byteofsoren/kicad_bytelib/3D/10A10-T/3D/10A10-T.stp

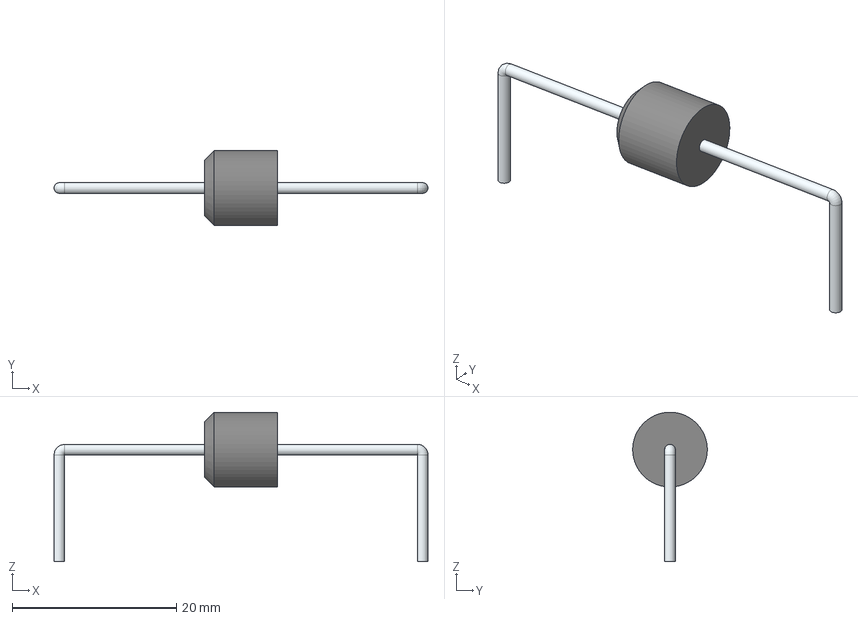
[picture p1: CAD file, 2021-05-24]
3D/10A10-T/3D/10A10-T.stp
45.5 x 9.10 x 18.2 mm
