byteofsoren/kicad_bytelib/3D/219-3LPSTR/3D/219-3LPSTR.stp

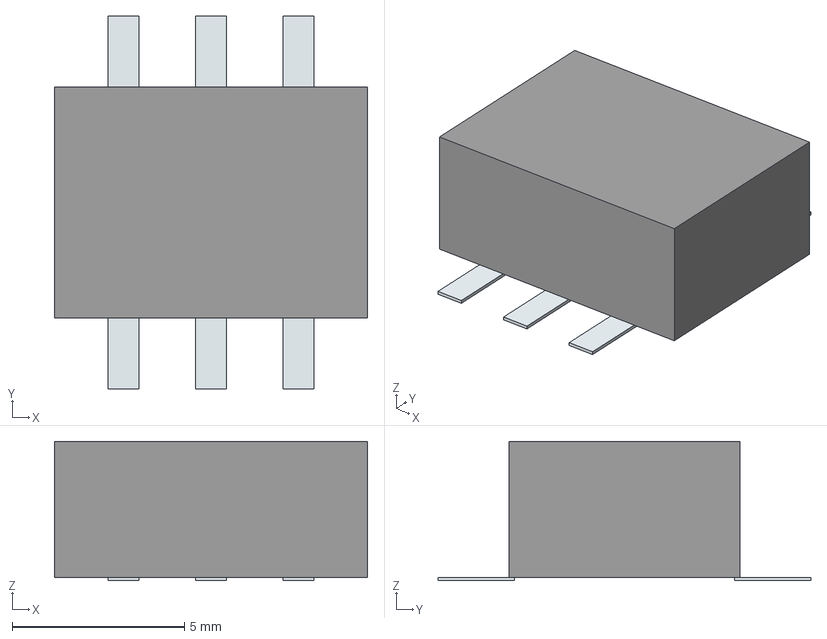
[picture p2: CAD file, 2021-05-24]
3D/219-3LPSTR/3D/219-3LPSTR.stp
9.09 x 10.8 x 4.05 mm
('pin',_'1')
('pin',_'2')
('pin',_'3')
('pin',_'4')
('pin',_'5')
('pin',_'6')
