byteofsoren/kicad_bytelib/3D/4628/3D/4628.stp

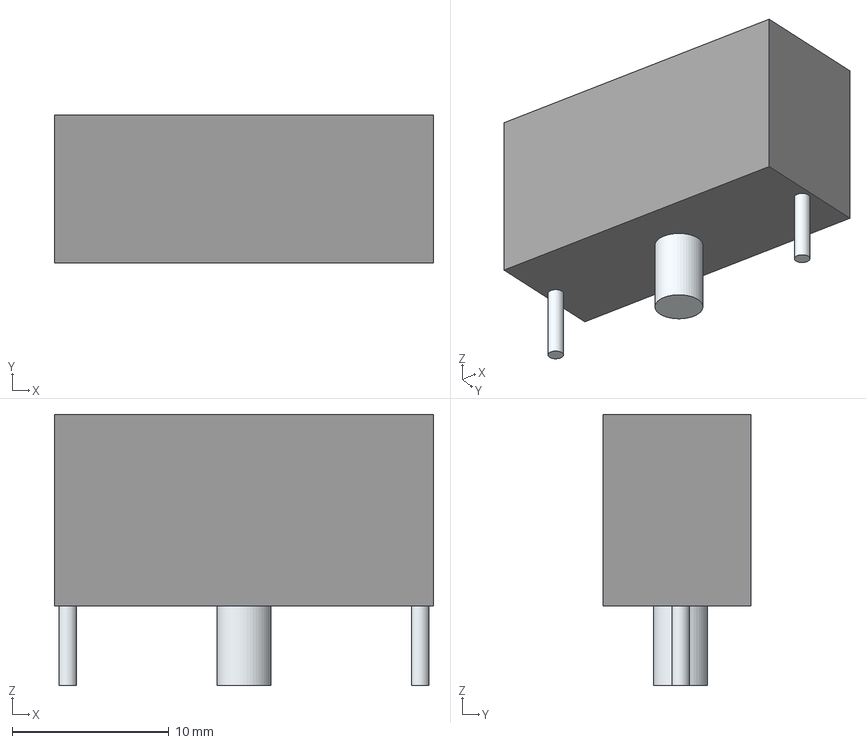
[picture p3: CAD file, 2021-05-24]
3D/4628/3D/4628.stp
24.2 x 9.45 x 17.3 mm
Leads x 3
