byteofsoren/kicad_bytelib/3D/ADS7830IPWR/3D/ADS7830IPWR.stp

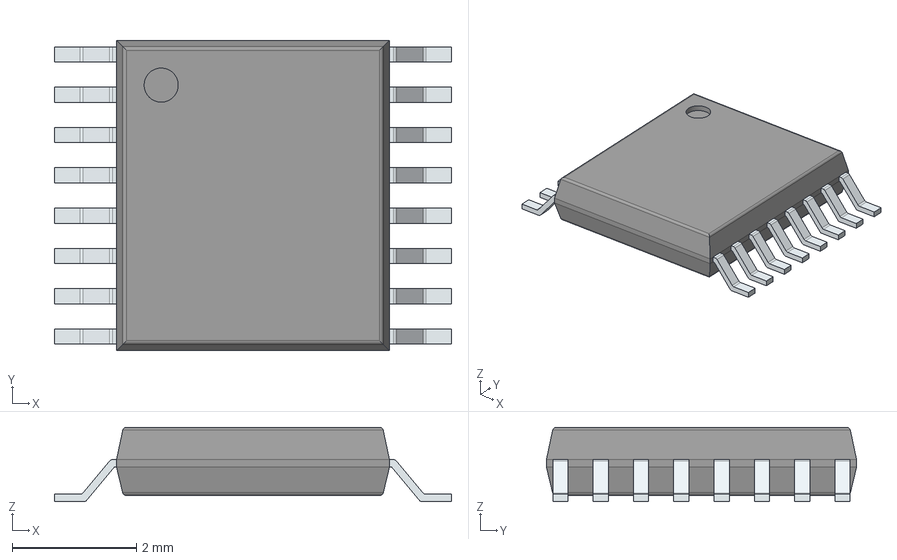
[picture p4: CAD file, 2021-05-24]
3D/ADS7830IPWR/3D/ADS7830IPWR.stp
6.40 x 5.00 x 1.20 mm
PinsArrayLR
