byteofsoren/kicad_bytelib/3D/ADUM1400ARWZ-RL/3D/ADUM1400ARWZ-RL.stp

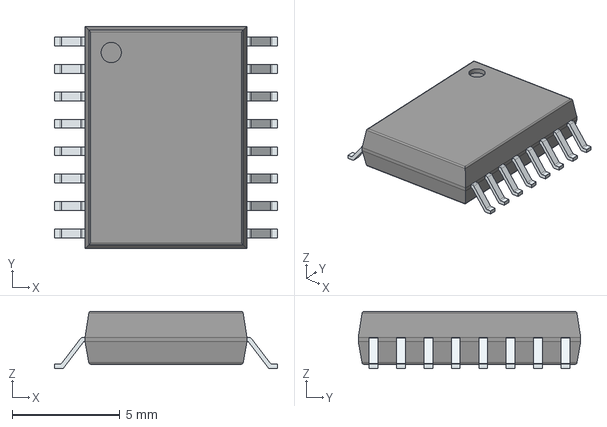
[picture p5: CAD file, 2021-05-24]
3D/ADUM1400ARWZ-RL/3D/ADUM1400ARWZ-RL.stp
10.3 x 10.3 x 2.65 mm
PinsArrayLR
