byteofsoren/kicad_bytelib/3D/CMI-9705-0580-SMT-TR/3D/CMI-9705-0580-SMT-TR.stp

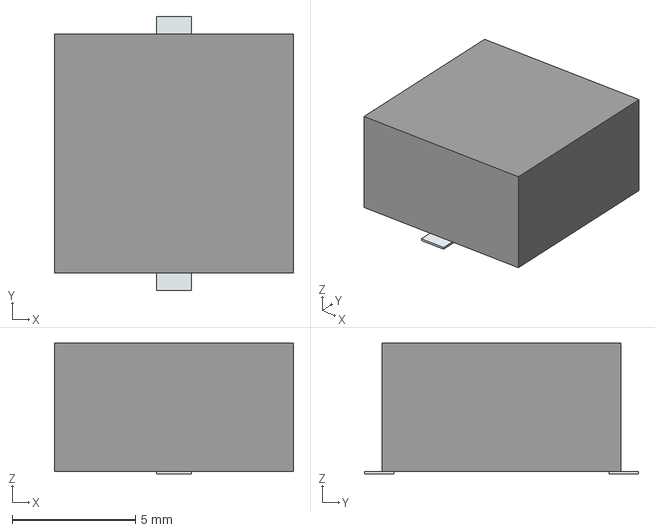
[picture p6: CAD file, 2021-05-24]
3D/CMI-9705-0580-SMT-TR/3D/CMI-9705-0580-SMT-TR.stp
9.70 x 11.1 x 5.30 mm
Pins
