byteofsoren/kicad_bytelib/3D/DLW44SM401SK2L/3D/DLW44SM401SK2L.stp

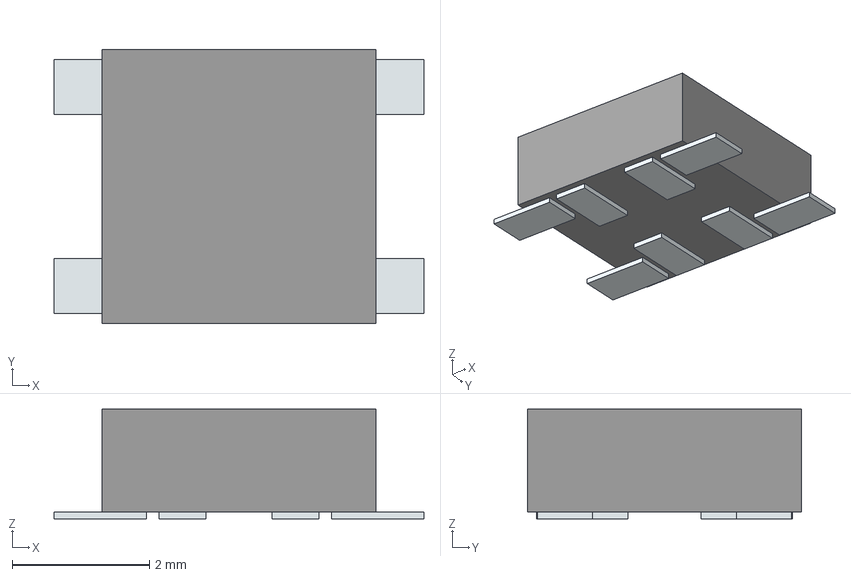
[picture p7: CAD file, 2021-05-24]
3D/DLW44SM401SK2L/3D/DLW44SM401SK2L.stp
5.40 x 4.00 x 1.60 mm
Pins
