byteofsoren/kicad_bytelib/3D/EDZCVT2R6.8B/3D/EDZCVT2R6.8B.stp

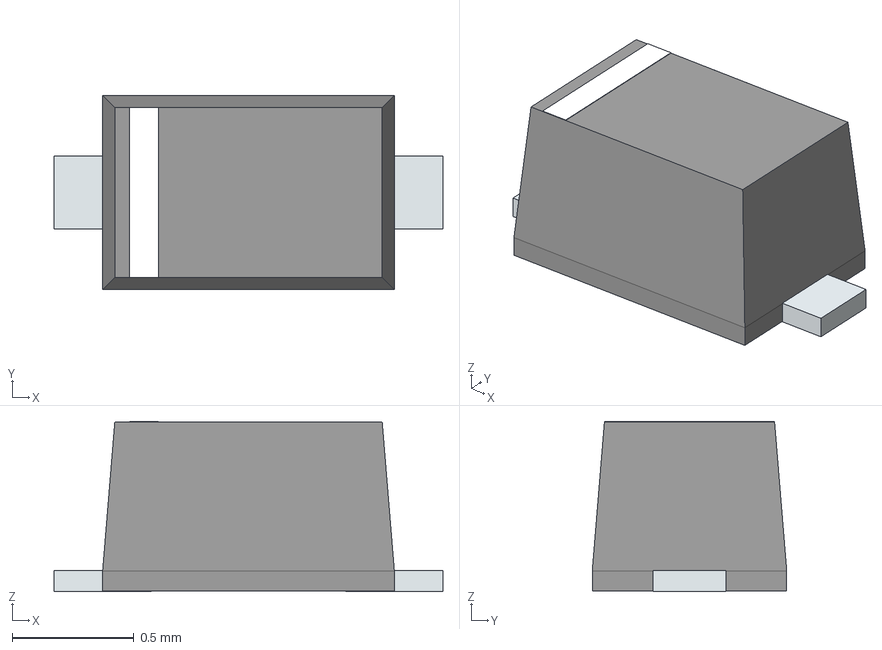
[picture p8: CAD file, 2021-05-24]
3D/EDZCVT2R6.8B/3D/EDZCVT2R6.8B.stp
1.60 x 0.8 x 0.7 mm
PinKIdent
PinK
PinA
