byteofsoren/kicad_bytelib/3D/FQT3P20TF/3D/FQT3P20TF.stp

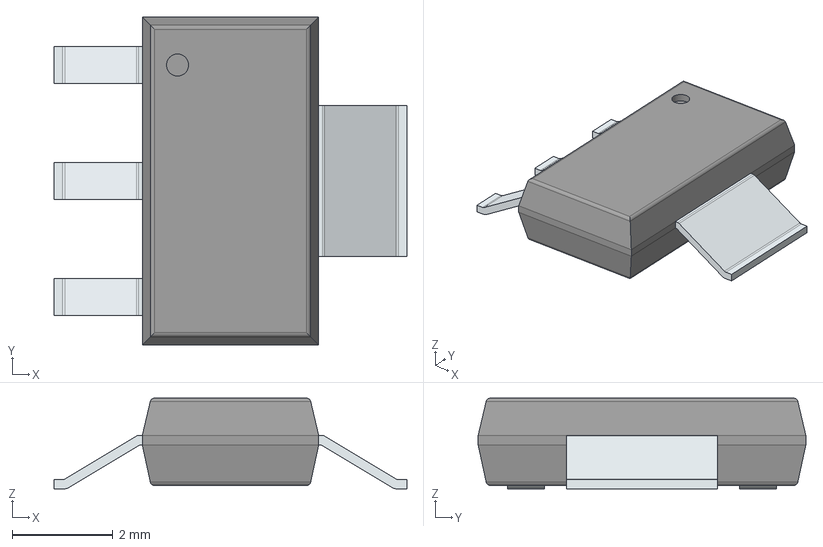
[picture p9: CAD file, 2021-05-24]
3D/FQT3P20TF/3D/FQT3P20TF.stp
7.00 x 6.50 x 1.80 mm
PinsArrayL
FilletPinR
