byteofsoren/kicad_bytelib/3D/IRF9520NPBF/3D/IRF9520NPBF.stp

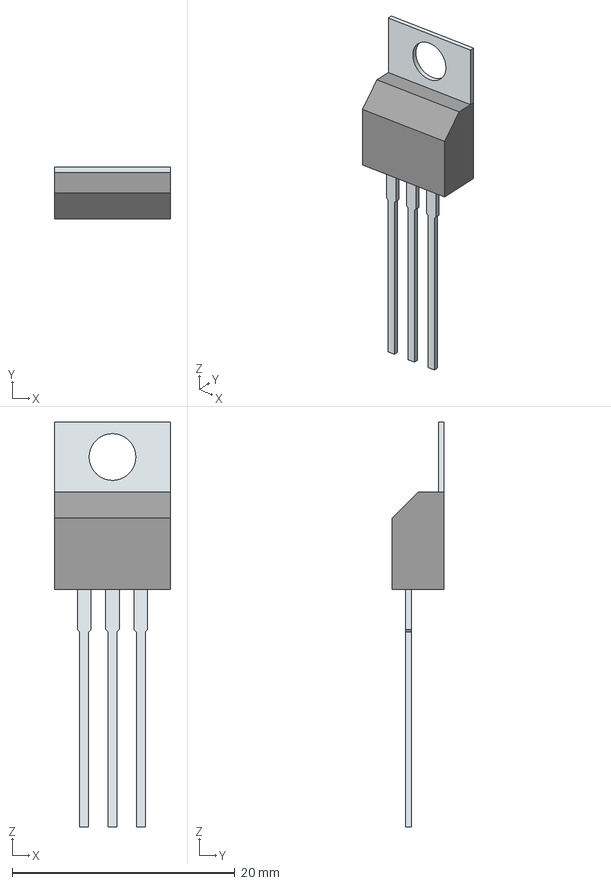
[picture p10: CAD file, 2021-05-24]
3D/IRF9520NPBF/3D/IRF9520NPBF.stp
10.4 x 4.69 x 36.4 mm
Tab
PinsArray
