byteofsoren/kicad_bytelib/3D/LCB717S/3D/LCB717S.stp

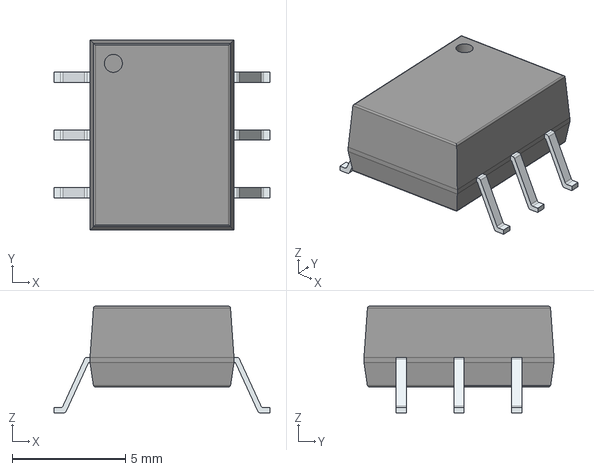
[picture p11: CAD file, 2021-05-24]
3D/LCB717S/3D/LCB717S.stp
9.52 x 8.38 x 4.70 mm
PinsArrayLR
