byteofsoren/kicad_bytelib/3D/LMZM23601V5SILR/3D/LMZM23601V5SILR.stp

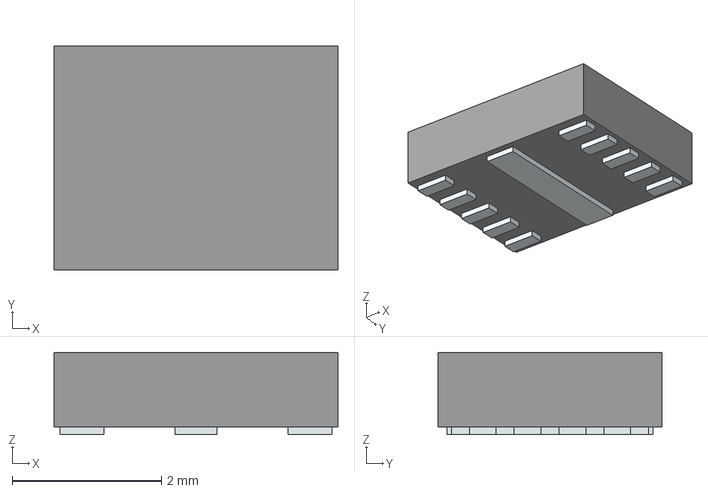
[picture p12: CAD file, 2021-05-24]
3D/LMZM23601V5SILR/3D/LMZM23601V5SILR.stp
3.80 x 3.00 x 1.10 mm
Pins
