byteofsoren/kicad_bytelib/3D/NFA18SL227V1A45L/3D/NFA18SL227V1A45L.stp

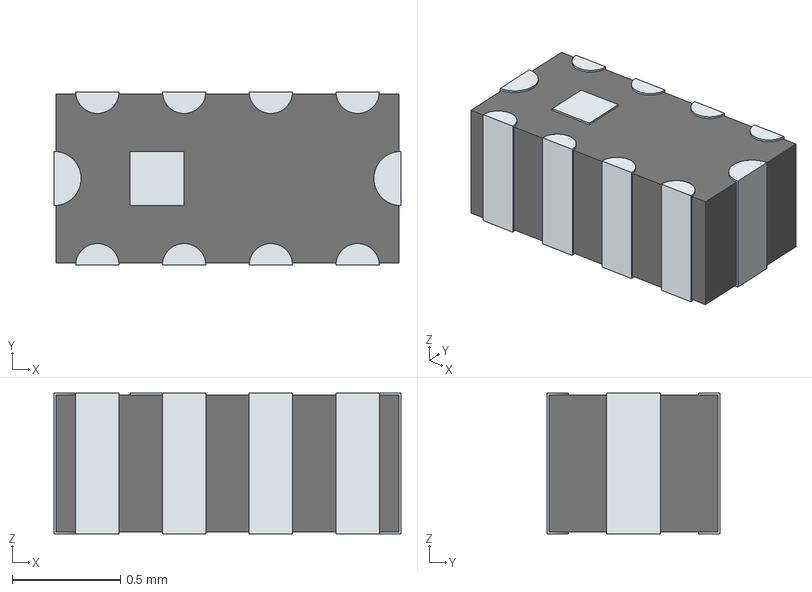
[picture p13: CAD file, 2021-05-24]
3D/NFA18SL227V1A45L/3D/NFA18SL227V1A45L.stp
1.60 x 0.8 x 0.65 mm
Rect1
Rect2
