byteofsoren/kicad_bytelib/3D/NFM21PC104R1E3D/3D/NFM21PC104R1E3D.stp

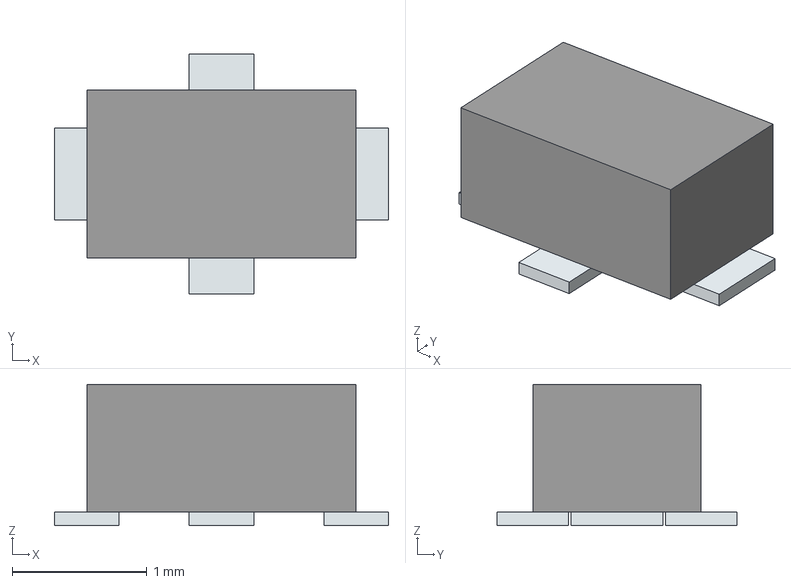
[picture p14: CAD file, 2021-05-24]
3D/NFM21PC104R1E3D/3D/NFM21PC104R1E3D.stp
2.48 x 1.78 x 1.05 mm
Pins
