byteofsoren/kicad_bytelib/3D/NTJS3151PT1G/3D/NTJS3151PT1G.stp

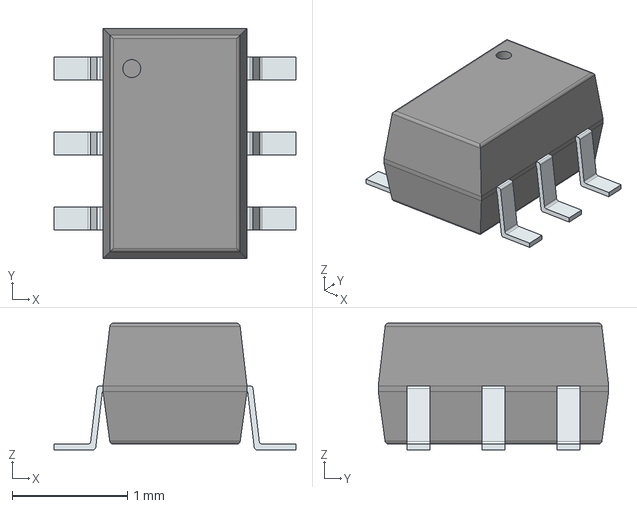
[picture p15: CAD file, 2021-05-24]
3D/NTJS3151PT1G/3D/NTJS3151PT1G.stp
2.10 x 2.00 x 1.10 mm
PinsArrayLR
