byteofsoren/kicad_bytelib/3D/NX2016SA-32M-EXS00A-CS06465/3D/NX2016SA-32M-EXS00A-CS06465.stp

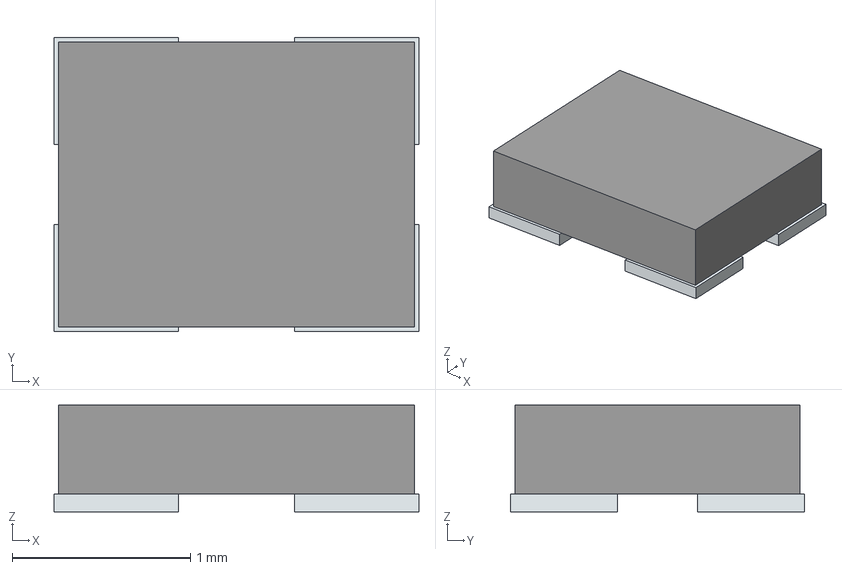
[picture p16: CAD file, 2021-05-24]
3D/NX2016SA-32M-EXS00A-CS06465/3D/NX2016SA-32M-EXS00A-CS06465.stp
2.05 x 1.65 x 0.6 mm
Pins
