byteofsoren/kicad_bytelib/3D/P78E05-1000/3D/P78E05-1000.stp

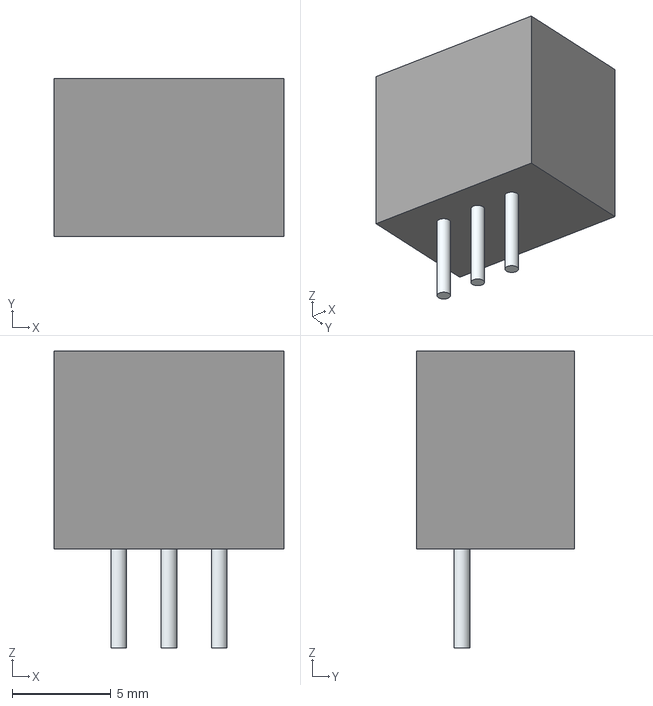
[picture p17: CAD file, 2021-05-24]
3D/P78E05-1000/3D/P78E05-1000.stp
11.6 x 8.00 x 15.0 mm
Leads x 3
