byteofsoren/kicad_bytelib/3D/PDQE15-Q24-S3-D/CUI_PDQE15-Q24-S3-D.step

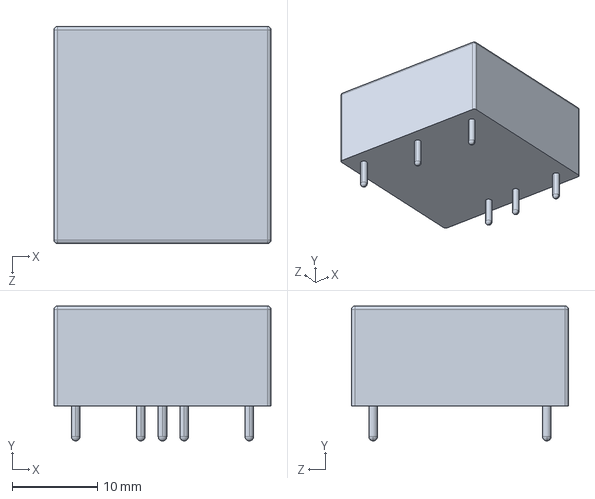
[picture p18: CAD file, 2021-05-24]
3D/PDQE15-Q24-S3-D/CUI_PDQE15-Q24-S3-D.step
25.4 x 15.8 x 25.4 mm
