byteofsoren/kicad_bytelib/3D/R82DC3330AA60J/3D/R82DC3330AA60J.stp

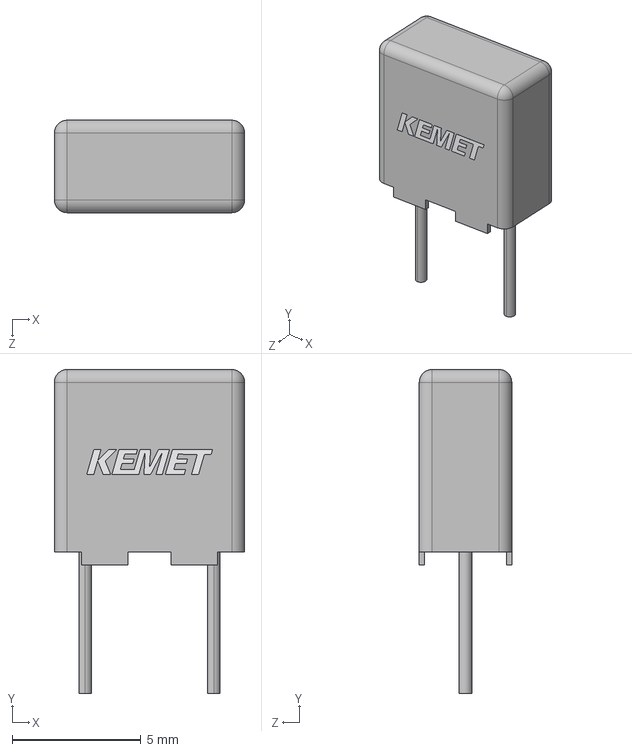
[picture p19: CAD file, 2021-05-24]
3D/R82DC3330AA60J/3D/R82DC3330AA60J.stp
7.40 x 12.6 x 3.60 mm
