byteofsoren/kicad_bytelib/3D/RPMB12-3.0-CT/3D/RPMB12-3.0-CT.stp

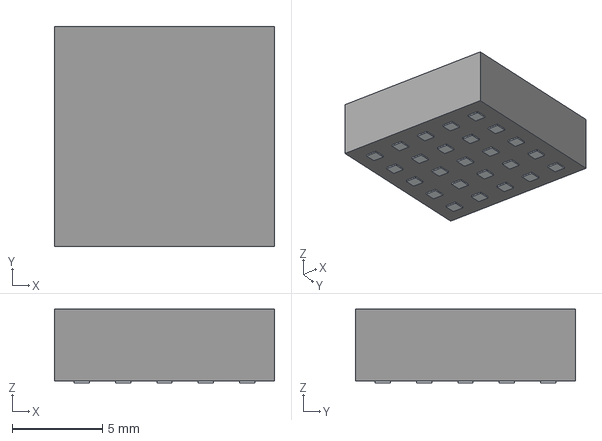
[picture p20: CAD file, 2021-05-24]
3D/RPMB12-3.0-CT/3D/RPMB12-3.0-CT.stp
12.2 x 12.2 x 4.10 mm
Pins
