byteofsoren/kicad_bytelib/3D/SI8602AC-B-ISR/3D/SI8602AC-B-ISR.stp

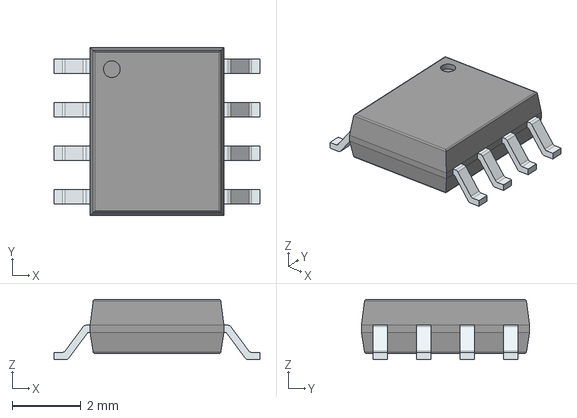
[picture p21: CAD file, 2021-05-24]
3D/SI8602AC-B-ISR/3D/SI8602AC-B-ISR.stp
6.00 x 4.90 x 1.75 mm
PinsArrayLR
