byteofsoren/kicad_bytelib/3D/SI8641AB-B-IS1R/3D/SI8641AB-B-IS1R.stp

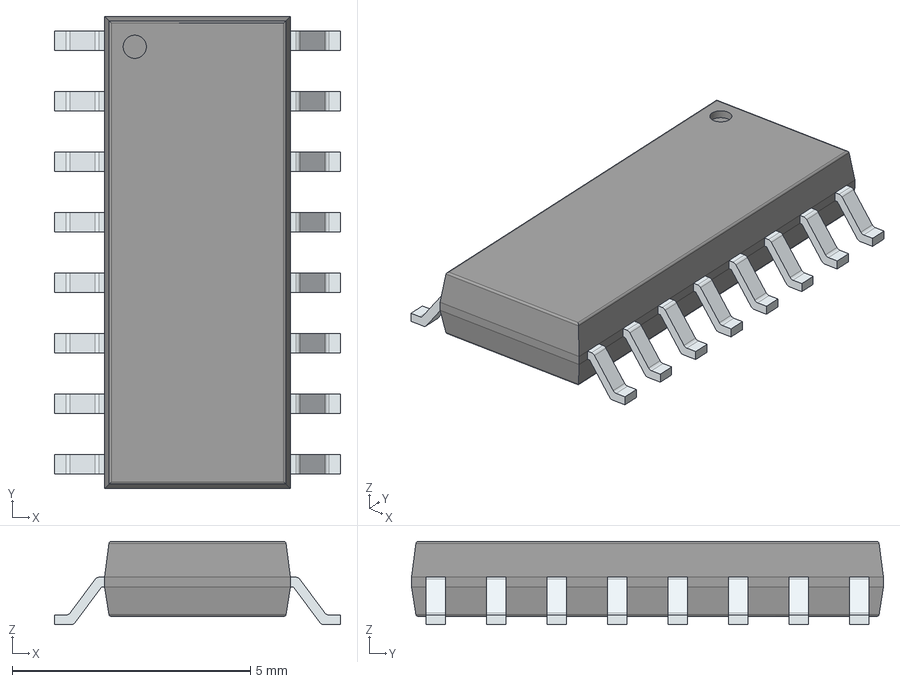
[picture p22: CAD file, 2021-05-24]
3D/SI8641AB-B-IS1R/3D/SI8641AB-B-IS1R.stp
6.00 x 9.90 x 1.75 mm
PinsArrayLR
