byteofsoren/kicad_bytelib/3D/SM4001PL-TP/3D/SM4001PL-TP.stp

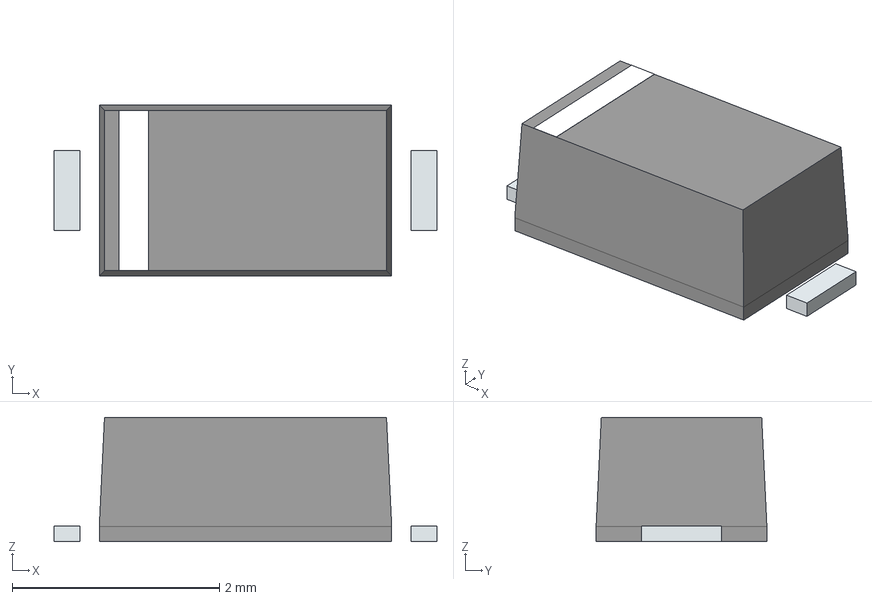
[picture p23: CAD file, 2021-05-24]
3D/SM4001PL-TP/3D/SM4001PL-TP.stp
3.70 x 1.65 x 1.20 mm
PinKIdent
PinK
PinA
