byteofsoren/kicad_bytelib/3D/STM32WB55RGV6/3D/STM32WB55RGV6.stp

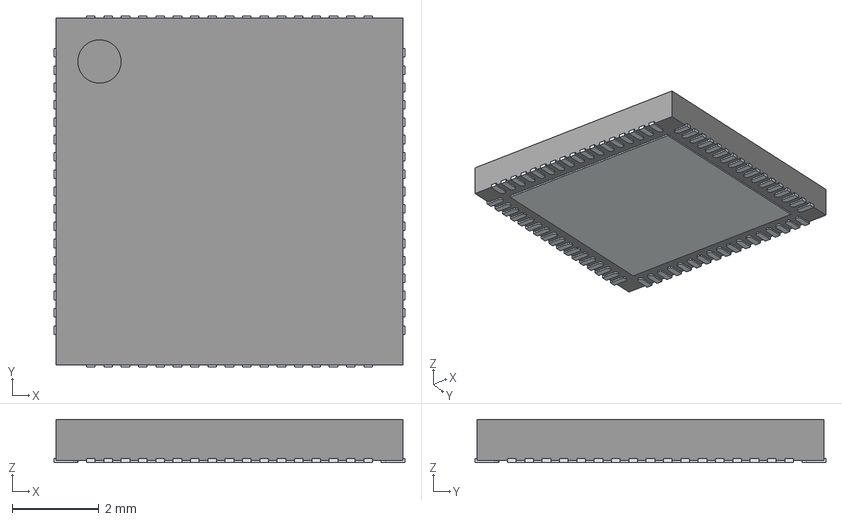
[picture p24: CAD file, 2021-05-24]
3D/STM32WB55RGV6/3D/STM32WB55RGV6.stp
8.10 x 8.10 x 1.00 mm
ThermalPin
PinsArrayLR
PinsArrayTB
