byteofsoren/kicad_bytelib/3D/TEN_60-2412WIN/3D/TEN_60-2412WIN.stp

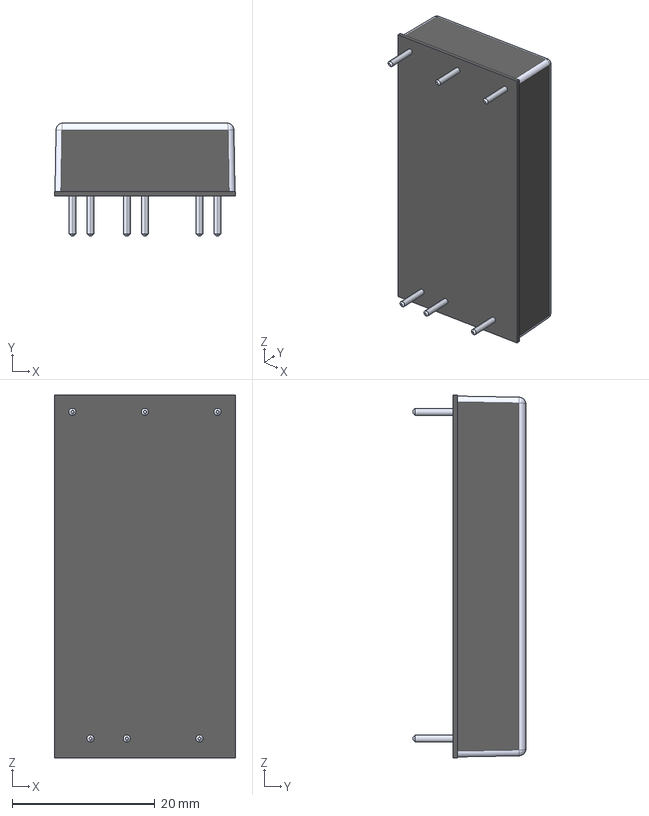
[picture p26: CAD file, 2021-05-24]
3D/TEN_60-2412WIN/3D/TEN_60-2412WIN.stp
25.4 x 15.8 x 50.8 mm
