byteofsoren/kicad_bytelib/3D/THJP/THJP1225A.stp

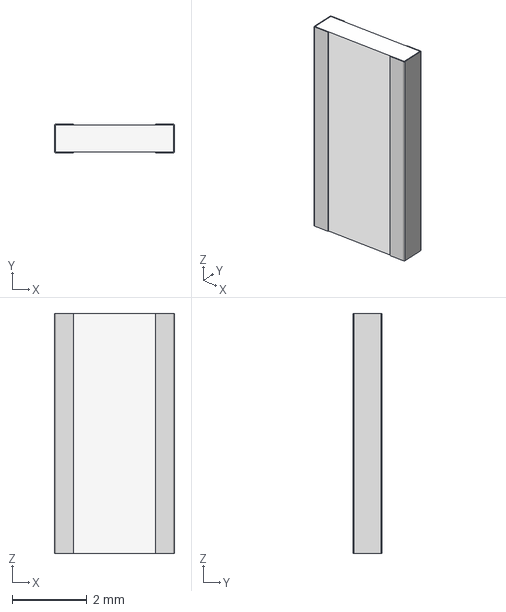
[picture p27: CAD file, 2021-05-24]
3D/THJP/THJP1225A.stp
3.20 x 0.762 x 6.40 mm
