byteofsoren/kicad_bytelib/3D/TMUX1247DCKR/3D/TMUX1247DCKR.stp

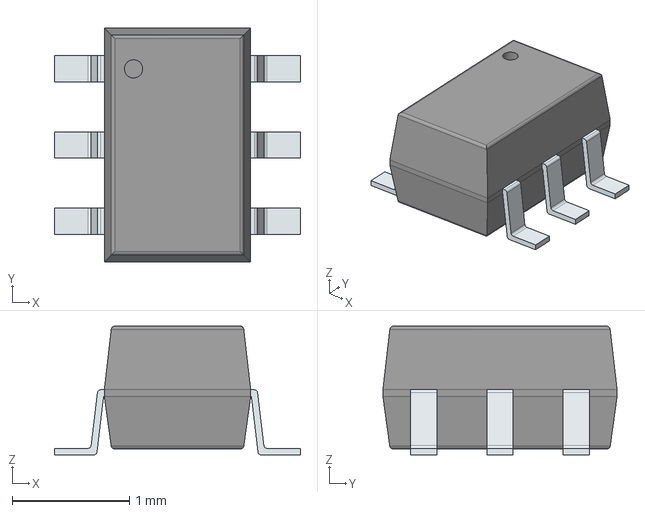
[picture p28: CAD file, 2021-05-24]
3D/TMUX1247DCKR/3D/TMUX1247DCKR.stp
2.10 x 2.00 x 1.10 mm
PinsArrayLR
