byteofsoren/kicad_bytelib/3D/TPS2120YFPR/3D/TPS2120YFPR.stp

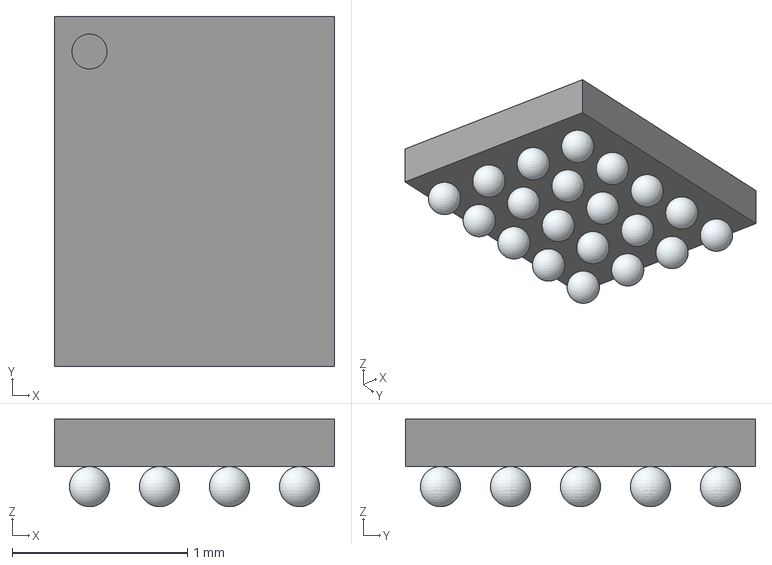
[picture p29: CAD file, 2021-05-24]
3D/TPS2120YFPR/3D/TPS2120YFPR.stp
1.60 x 2.00 x 0.5 mm
