byteofsoren/kicad_bytelib/3D/TSC-124D3H,000/3D/TSC-124D3H,000.stp

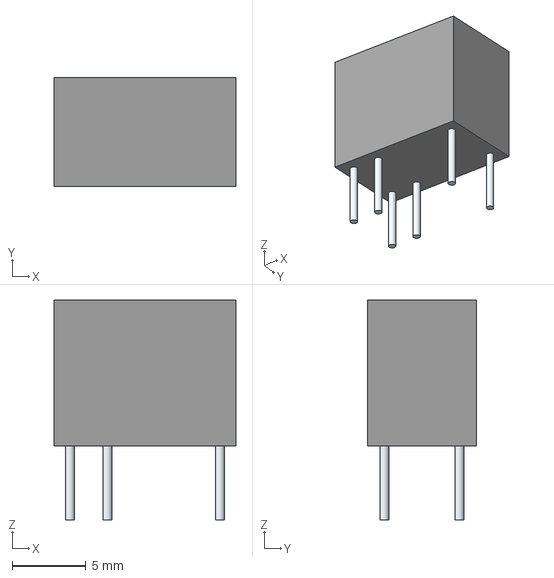
[picture p30: CAD file, 2021-05-24]
3D/TSC-124D3H,000/3D/TSC-124D3H,000.stp
12.3 x 7.40 x 14.9 mm
Leads x 6
