byteofsoren/kicad_bytelib/3D/UA78M33CDCYR/3D/UA78M33CDCYR.stp

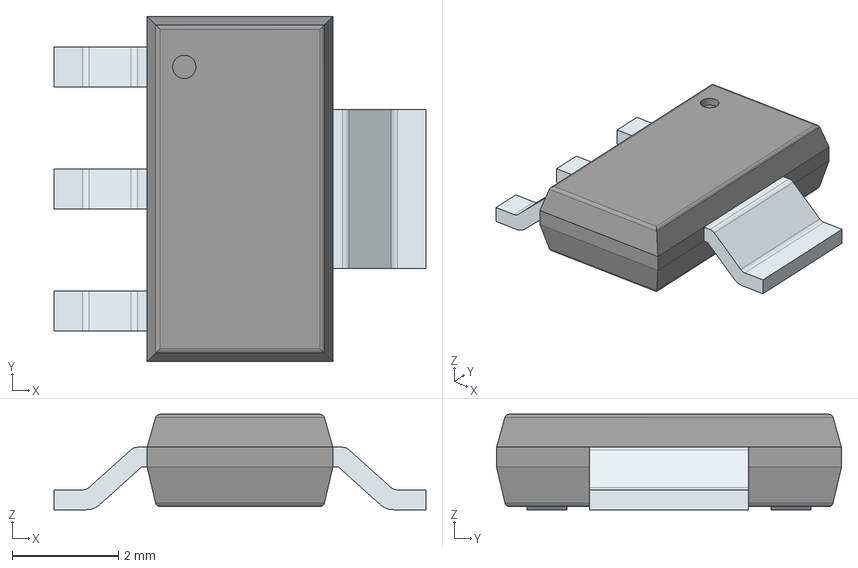
[picture p31: CAD file, 2021-05-24]
3D/UA78M33CDCYR/3D/UA78M33CDCYR.stp
7.00 x 6.50 x 1.80 mm
PinsArrayL
FilletPinR
