byteofsoren/kicad_bytelib/3D/UWT1H101MNL1GS/3D/UWT1H101MNL1GS.stp

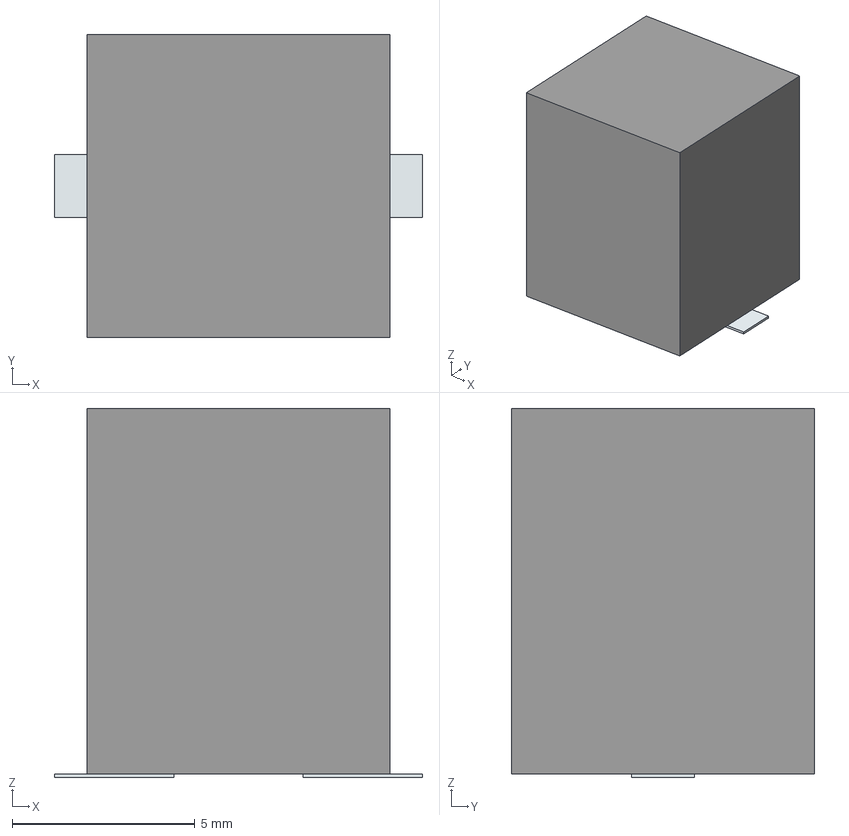
[picture p32: CAD file, 2021-05-24]
3D/UWT1H101MNL1GS/3D/UWT1H101MNL1GS.stp
10.1 x 8.30 x 10.1 mm
('pin',_'1')
('pin',_'2')
