byteofsoren/kicad_bytelib/3D/WCAP-ASLI_rev19a/10x10R5x4R5/10x10.5x4.5.stp

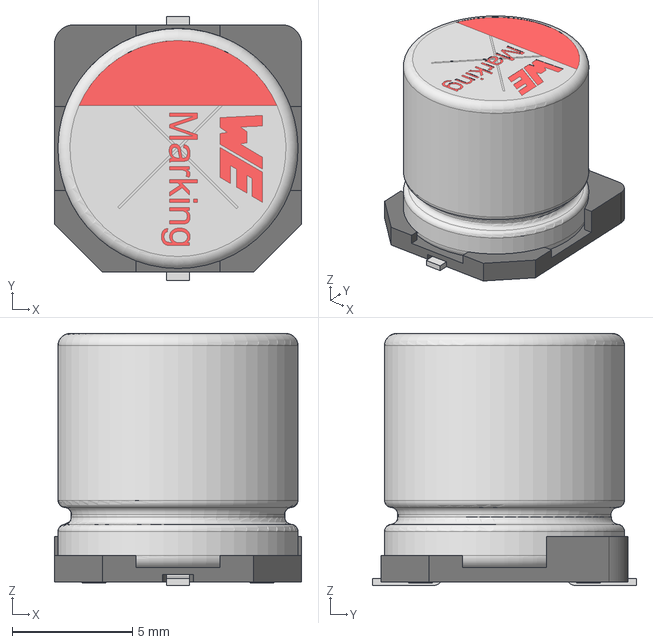
[picture p33: CAD file, 2021-05-24]
3D/WCAP-ASLI_rev19a/10x10R5x4R5/10x10.5x4.5.stp
10.3 x 11.0 x 10.5 mm
capicitor_10x10.5x4.5
Base_Φ10Capacitor
