byteofsoren/kicad_bytelib/3D/WCAP-ASLI_rev19a/12R5x14x4R5/12.5x14x4.5.stp

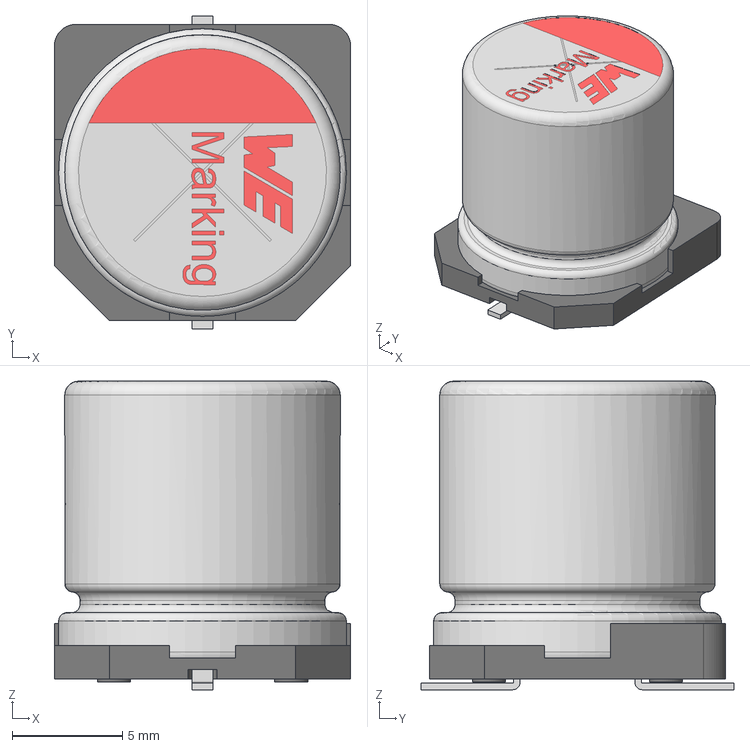
[picture p34: CAD file, 2021-05-24]
3D/WCAP-ASLI_rev19a/12R5x14x4R5/12.5x14x4.5.stp
13.4 x 14.2 x 14.0 mm
capicitor_12.5x14x4.5
Base_Φ13Capacitor
