byteofsoren/kicad_bytelib/3D/WCAP-ASLI_rev19a/16x17x7/16x17x7.stp

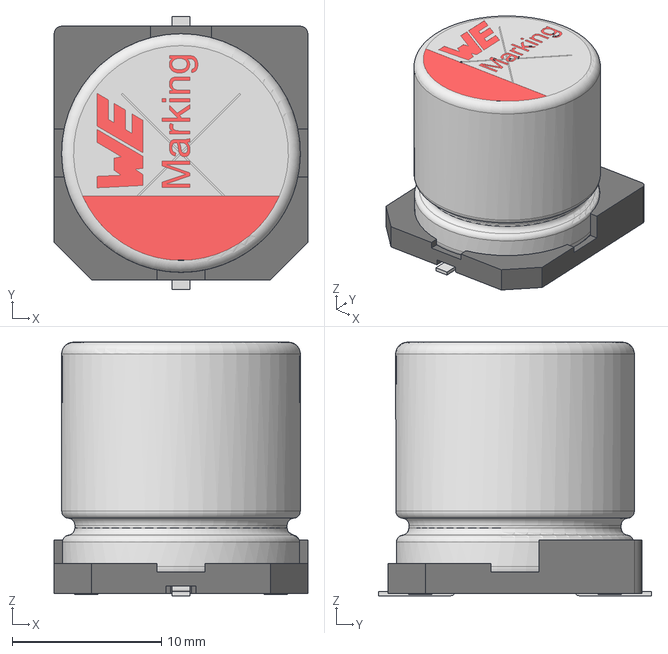
[picture p35: CAD file, 2021-05-24]
3D/WCAP-ASLI_rev19a/16x17x7/16x17x7.stp
17.0 x 18.3 x 17.0 mm
Base_Φ16Capacitor
capicitor_16x17x7
