byteofsoren/kicad_bytelib/3D/WCAP-ASLI_rev19a/4x5R5x1/4x5.5x1.stp

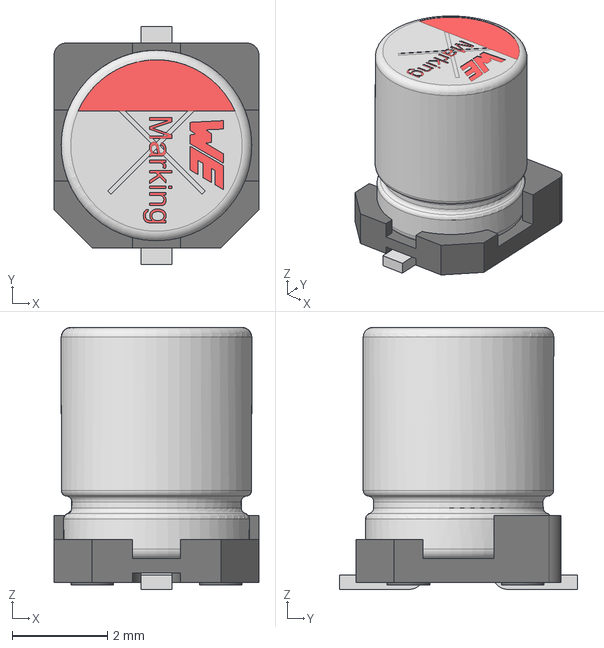
[picture p36: CAD file, 2021-05-24]
3D/WCAP-ASLI_rev19a/4x5R5x1/4x5.5x1.stp
4.30 x 5.00 x 5.50 mm
capicitor_4x5.5x1
Base_Φ4Capacitor
