byteofsoren/kicad_bytelib/3D/WCAP-ASLI_rev19a/5x5R5x1R4/5x5.5x1.4.stp

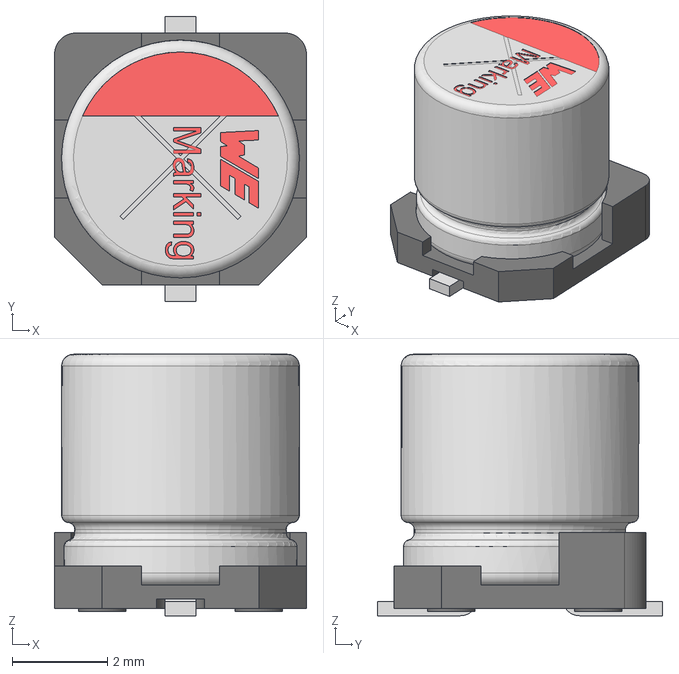
[picture p37: CAD file, 2021-05-24]
3D/WCAP-ASLI_rev19a/5x5R5x1R4/5x5.5x1.4.stp
5.30 x 6.00 x 5.50 mm
capicitor_5x5.5x1.4
Base_Φ5Capacitor
