byteofsoren/kicad_bytelib/3D/WCAP-ASLI_rev19a/6R3x7R7x2R2/6.3x7.7x2.2.stp

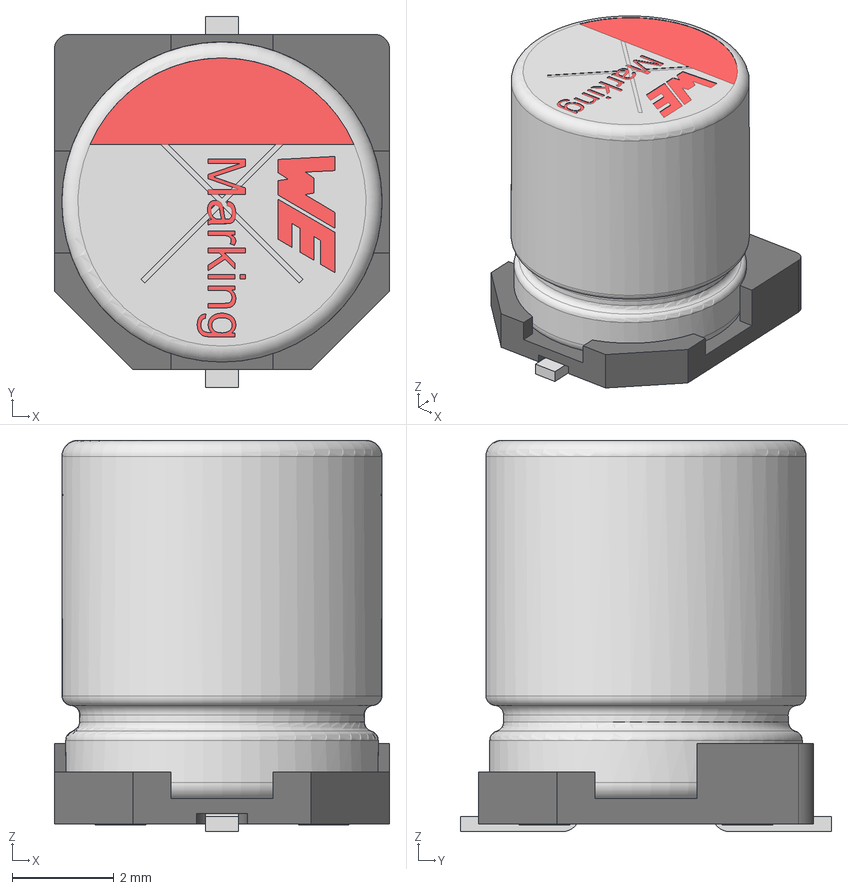
[picture p38: CAD file, 2021-05-24]
3D/WCAP-ASLI_rev19a/6R3x7R7x2R2/6.3x7.7x2.2.stp
6.60 x 7.30 x 7.70 mm
capicitor_6.3x7.7x2.2
Base_Φ6_3Capacitor
