byteofsoren/kicad_bytelib/3D/WCAP-ASLI_rev19a/8x10R5x3R1/8x10.5x3.1.stp

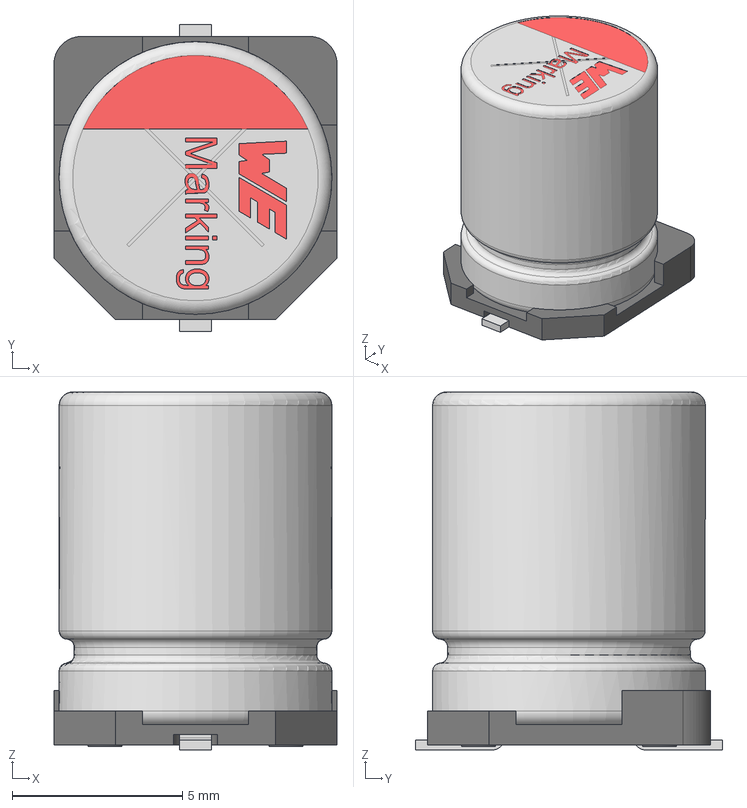
[picture p39: CAD file, 2021-05-24]
3D/WCAP-ASLI_rev19a/8x10R5x3R1/8x10.5x3.1.stp
8.30 x 9.00 x 10.5 mm
capicitor_8x10.5x3.1
Base_Φ8Capacitor
