byteofsoren/kicad_bytelib/3D/WCAP-ASLI_rev19a/8x6R5x2R3/8x6.5x2.3.stp

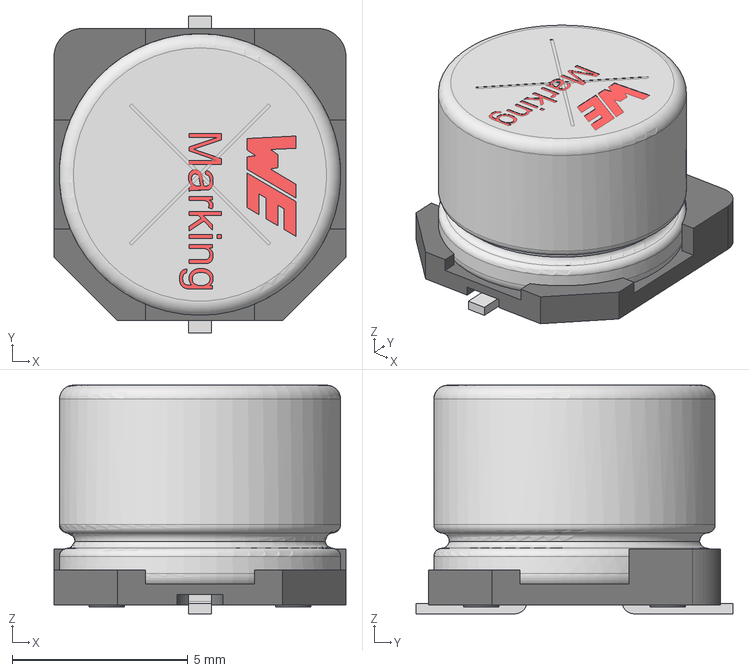
[picture p40: CAD file, 2021-05-24]
3D/WCAP-ASLI_rev19a/8x6R5x2R3/8x6.5x2.3.stp
8.30 x 9.00 x 6.50 mm
capicitor_8x6.5x2.3
Base_Φ8Capacitor
