byteofsoren/kicad_bytelib/3D/WE-PD_744777.stp

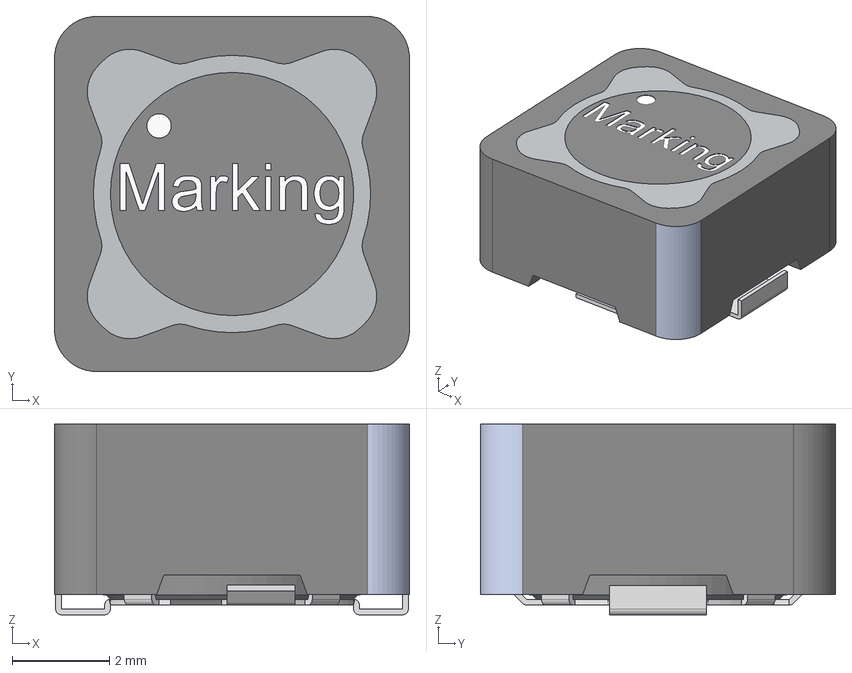
[picture p41: CAD file, 2022-03-26]
3D/WE-PD_744777.stp
7.30 x 7.30 x 3.92 mm
Ring
Core
Base x 2
Glue x 3
