byteofsoren/kicad_bytelib/3D/THJP/THJP0805A.stp

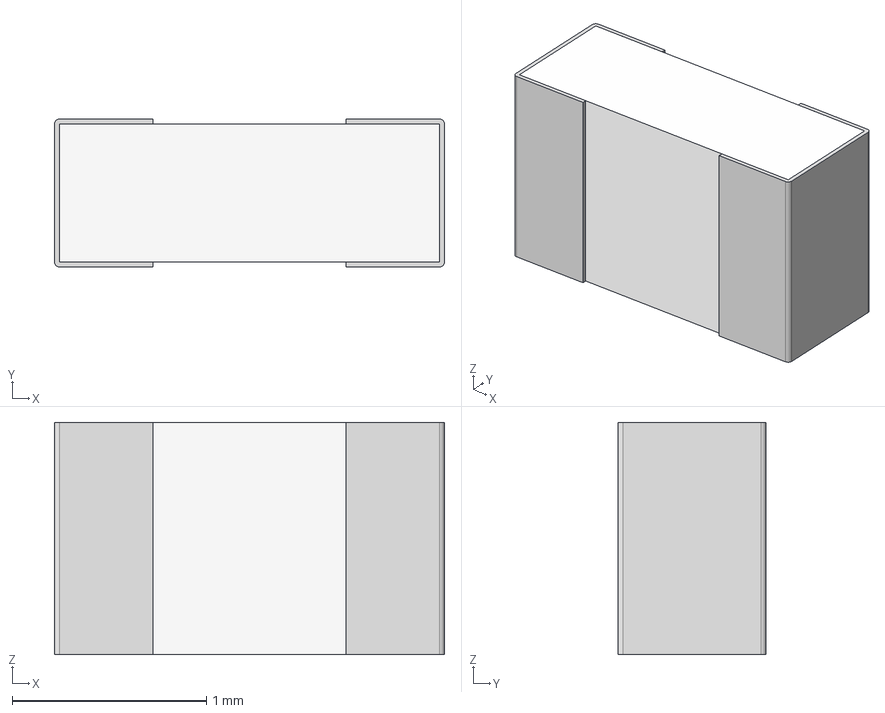
[picture p43: CAD file, 2021-05-24]
3D/THJP/THJP0805A.stp
2.01 x 0.762 x 1.19 mm
