byteofsoren/kicad_bytelib/3D/TBL009V-254/CUI_DEVICES_TBL009V-254-05GY-2GY.step

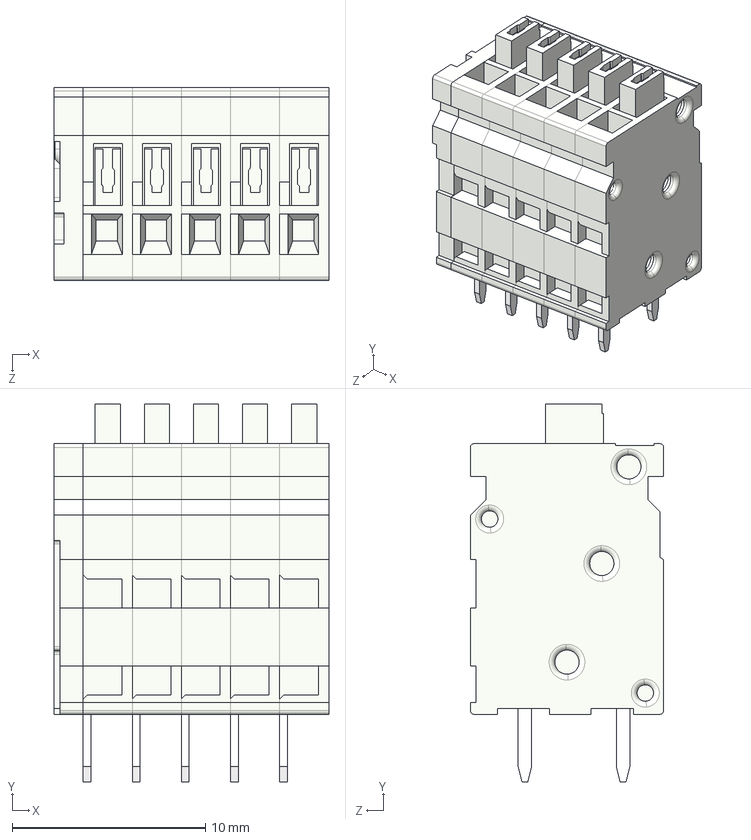
[picture p44: CAD file, 2021-05-24]
3D/TBL009V-254/CUI_DEVICES_TBL009V-254-05GY-2GY.step
14.2 x 19.6 x 10.0 mm
TBL009V-254 - END CAP_Gray
TBL009V-254 - BODY_Gray x 5
TBL009V-254 - PUSH BUTTON_Gray x 5
