byteofsoren/kicad_bytelib/3D/THJP/THJP0612A.stp

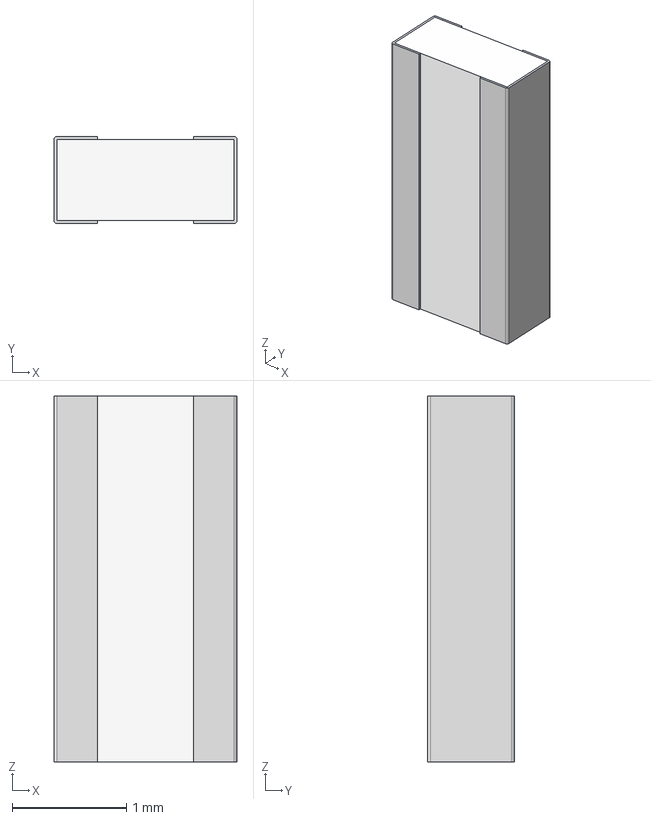
[picture p45: CAD file, 2021-05-24]
3D/THJP/THJP0612A.stp
1.60 x 0.762 x 3.20 mm
