byteofsoren/kicad_bytelib/3D/TBL009V-254/CUI_DEVICES_TBL009V-254-12GY-2GY.step

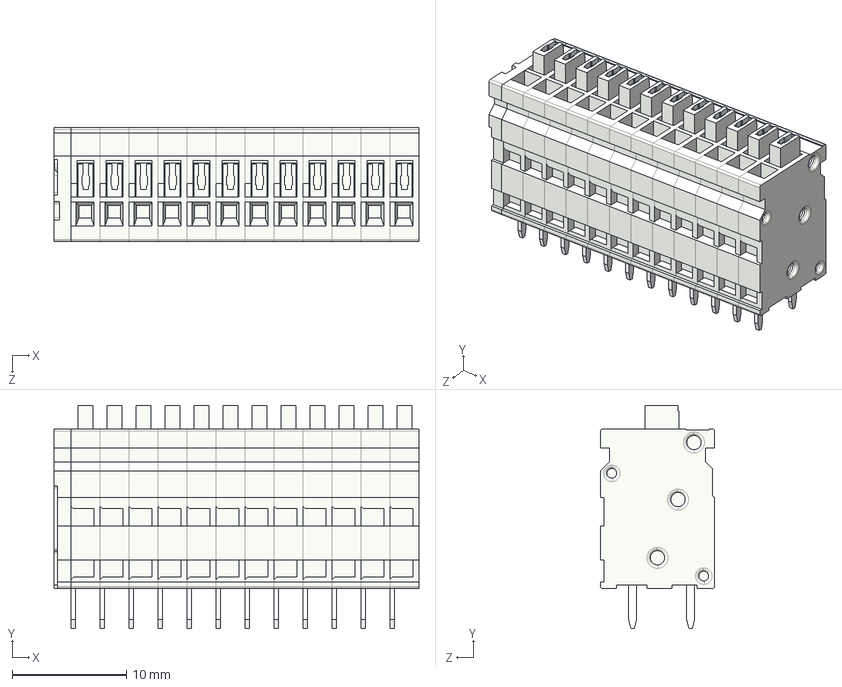
[picture p46: CAD file, 2021-05-24]
3D/TBL009V-254/CUI_DEVICES_TBL009V-254-12GY-2GY.step
32.0 x 19.6 x 10.0 mm
TBL009V-254 - END CAP_Gray
TBL009V-254 - BODY_Gray x 12
TBL009V-254 - PUSH BUTTON_Gray x 12
