byteofsoren/kicad_bytelib/3D/THJP/THJP1206A.stp

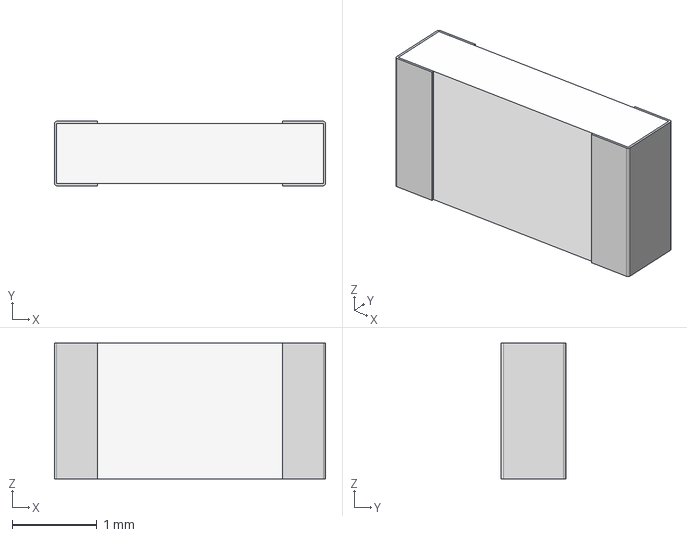
[picture p47: CAD file, 2021-05-24]
3D/THJP/THJP1206A.stp
3.20 x 0.762 x 1.60 mm
