byteofsoren/kicad_bytelib/3D/THN_15-1210.stp

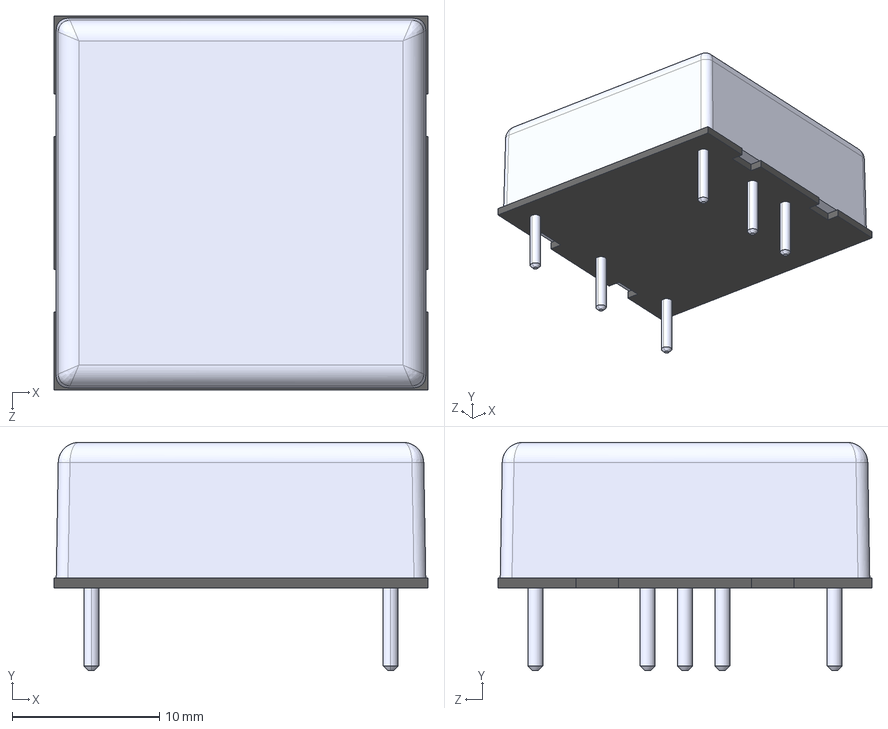
[picture p48: CAD file, 2022-01-19]
3D/THN_15-1210.stp
25.4 x 15.5 x 25.4 mm
