byteofsoren/kicad_bytelib/3D/THJP/THJP0603A.stp

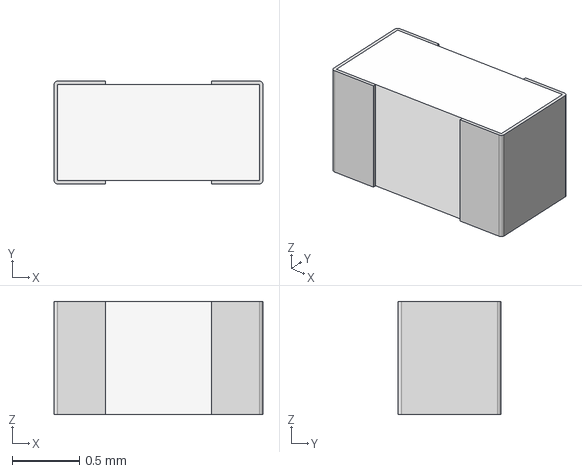
[picture p49: CAD file, 2021-05-24]
3D/THJP/THJP0603A.stp
1.55 x 0.762 x 0.838 mm
