byteofsoren/kicad_bytelib/3D/WE-CNSW_1206_CNSW.stp

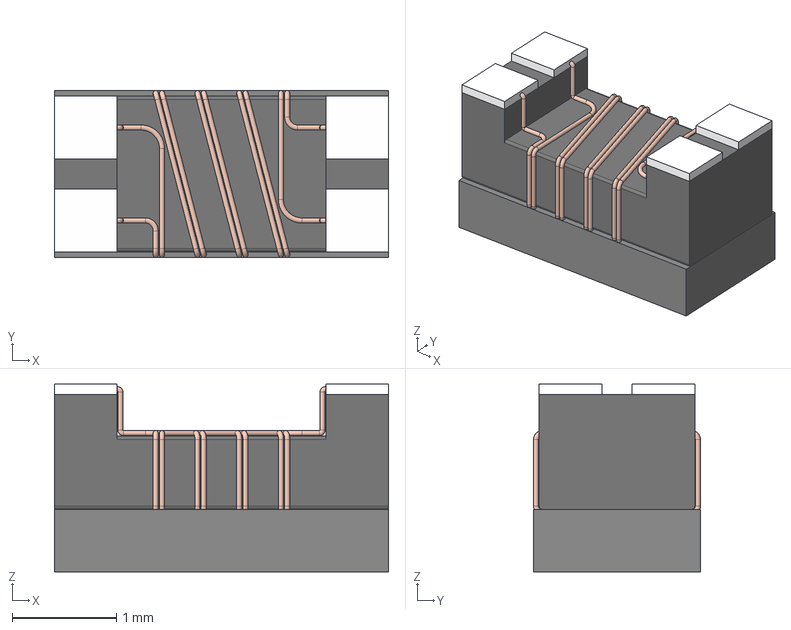
[picture p50: CAD file, 2021-12-19]
3D/WE-CNSW_1206_CNSW.stp
3.20 x 1.60 x 1.80 mm
Gehäuse x 3
Boden
Lötfläche x 4
