byteofsoren/kicad_bytelib/3D/THJP/THJP2512A.stp

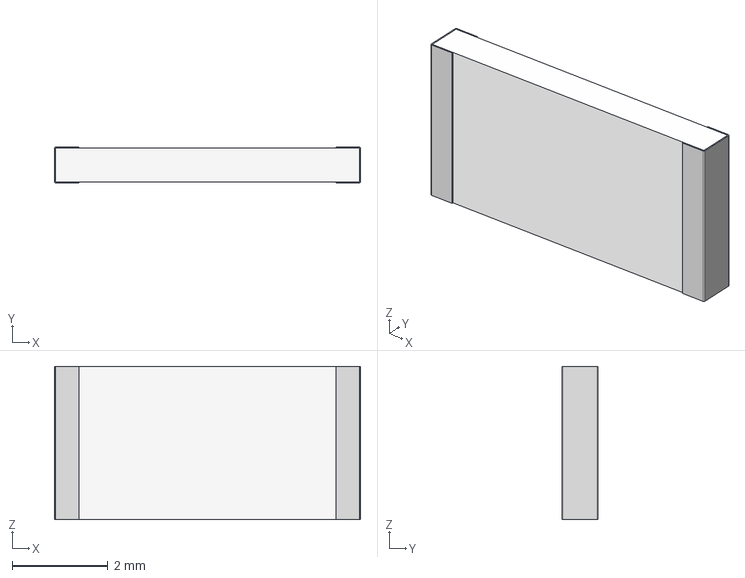
[picture p51: CAD file, 2021-05-24]
3D/THJP/THJP2512A.stp
6.40 x 0.762 x 3.20 mm
