byteofsoren/kicad_bytelib/3D/ADUM4160BRIZ-RL.stp

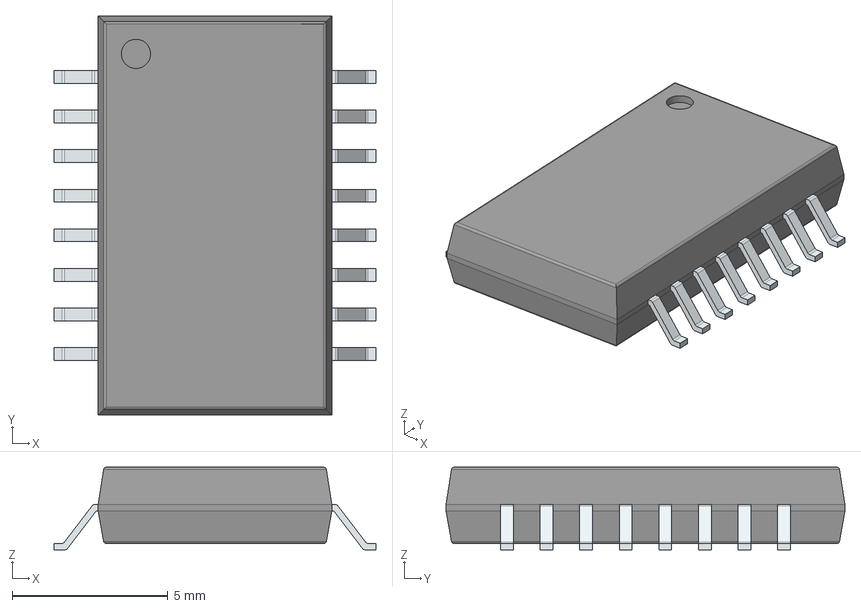
[picture p52: CAD file, 2021-09-27]
3D/ADUM4160BRIZ-RL.stp
10.3 x 12.8 x 2.65 mm
PinsArrayLR
