byteofsoren/kicad_bytelib/3D/TL3780AF240QG.stp

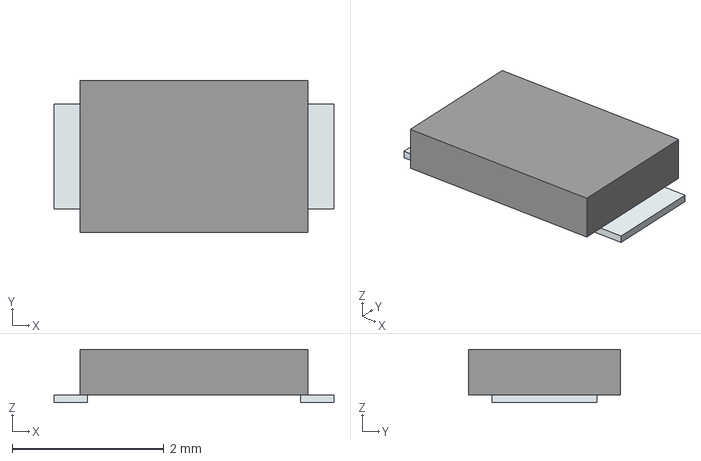
[picture p53: CAD file, 2021-09-27]
3D/TL3780AF240QG.stp
3.69 x 2.00 x 0.7 mm
Pins
