byteofsoren/kicad_bytelib/3D/TEN_3-0510N.stp

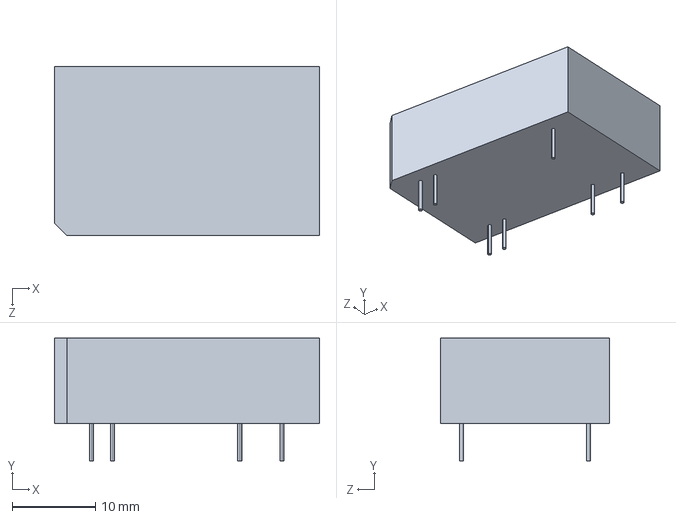
[picture p54: CAD file, 2021-09-27]
3D/TEN_3-0510N.stp
31.8 x 14.7 x 20.3 mm
