byteofsoren/kicad_bytelib/3D/TPS2121RUXR.step

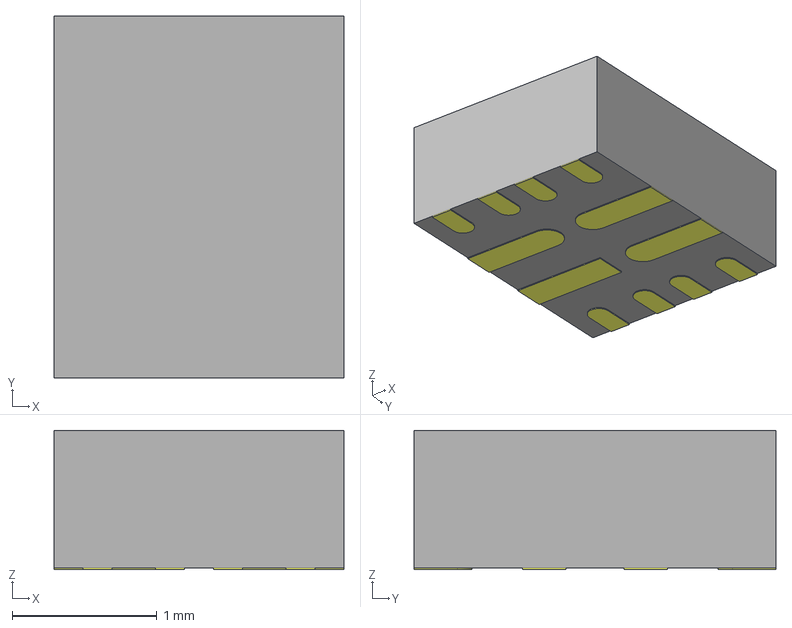
[picture p55: CAD file, 2021-08-03]
3D/TPS2121RUXR.step
2.00 x 2.50 x 0.96 mm
