byteofsoren/kicad_bytelib/3D/CUI_DEVICES_TBL002A-350-06GR-2OR.step

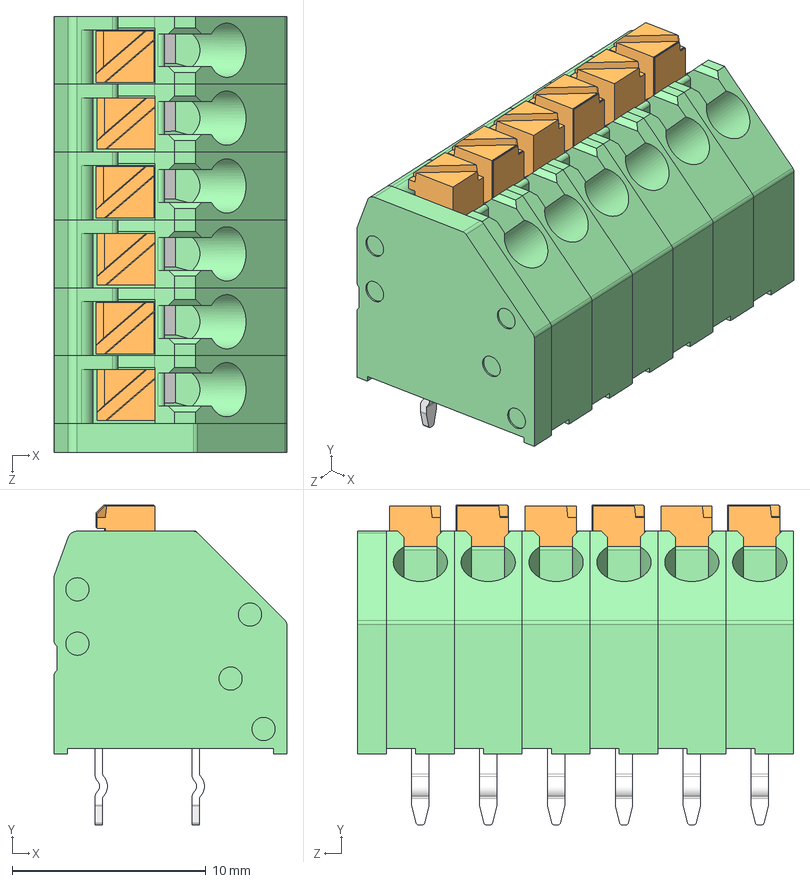
[picture p56: CAD file, 2021-08-01]
3D/CUI_DEVICES_TBL002A-350-06GR-2OR.step
12.0 x 16.5 x 22.5 mm
TBL002A-350 - END CAP_Green
TBL002A-350 - BODY A_Green x 3
TBL002A-350 - BODY B_Green x 3
TBL002A-350 - PUSH BUTTON A_Orange x 3
TBL002A-350 - PUSH BUTTON B_Orange x 3
