byteofsoren/kicad_bytelib/3D/test.step

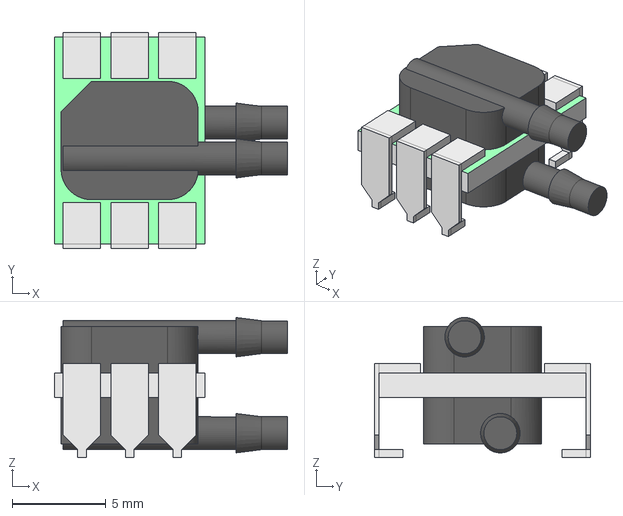
[picture p58: CAD file, 2021-05-24]
3D/test.step
12.4 x 11.5 x 7.45 mm
