byteofsoren/kicad_bytelib/3D/usb_c_12401598E4#2A.stl

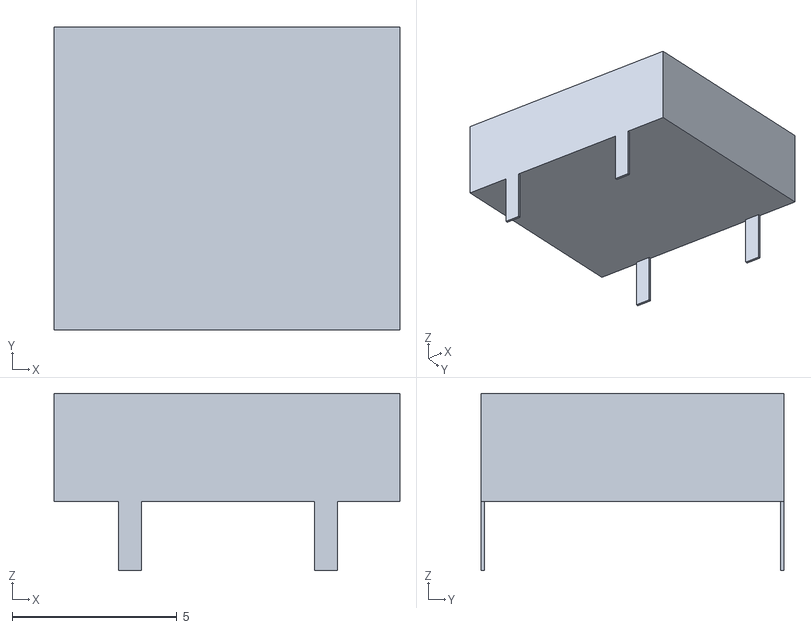
[picture p59: CAD file, 2021-05-24]
3D/usb_c_12401598E4#2A.stl
10.5 x 9.18 x 5.38
