byteofsoren/kicad_bytelib/3D/HR10A-10R-12SB.step

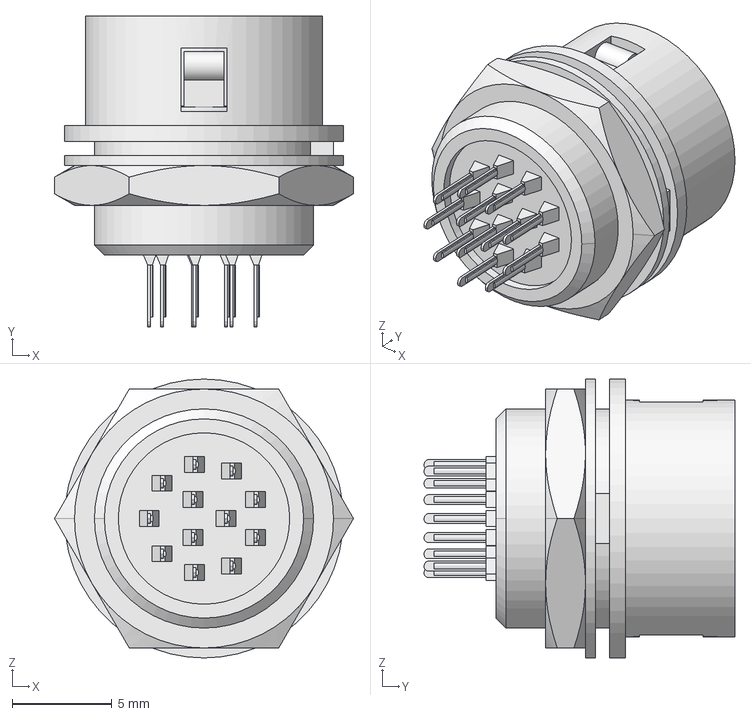
[picture p60: CAD file, 2021-05-24]
3D/HR10A-10R-12SB.step
15.0 x 15.6 x 14.0 mm
