byteofsoren/kicad_bytelib/3D/WE-UNIT_E13_7_4_horizontal.stp

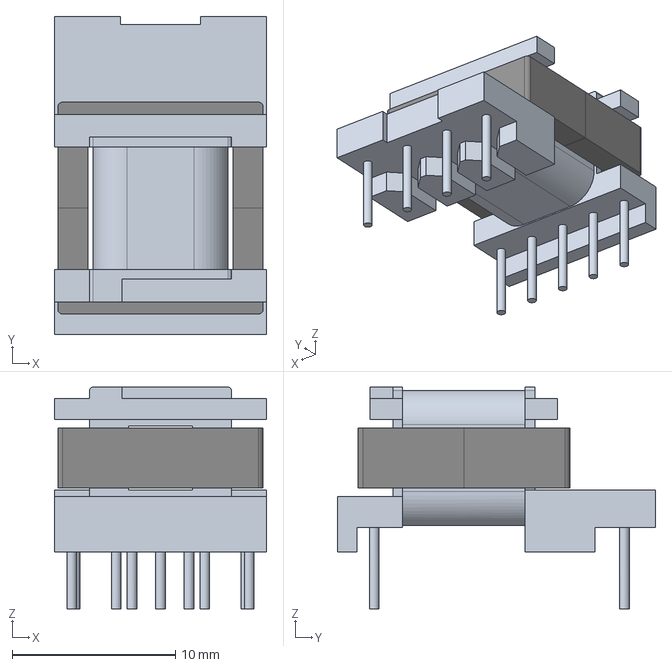
[picture p61: CAD file, 2021-05-24]
3D/WE-UNIT_E13_7_4_horizontal.stp
13.0 x 19.5 x 13.6 mm
