byteofsoren/kicad_bytelib/3D/EVQ-Q2U03W-Body.stl

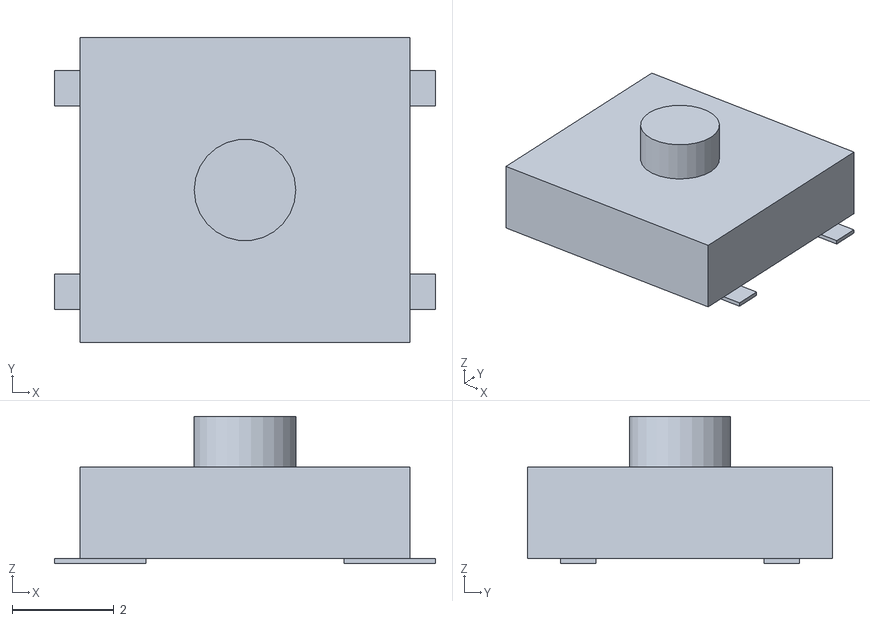
[picture p62: CAD file, 2021-05-24]
3D/EVQ-Q2U03W-Body.stl
7.50 x 6.00 x 2.90
