byteofsoren/kicad_bytelib/3D/VS-3EYH01-M3_H.stp

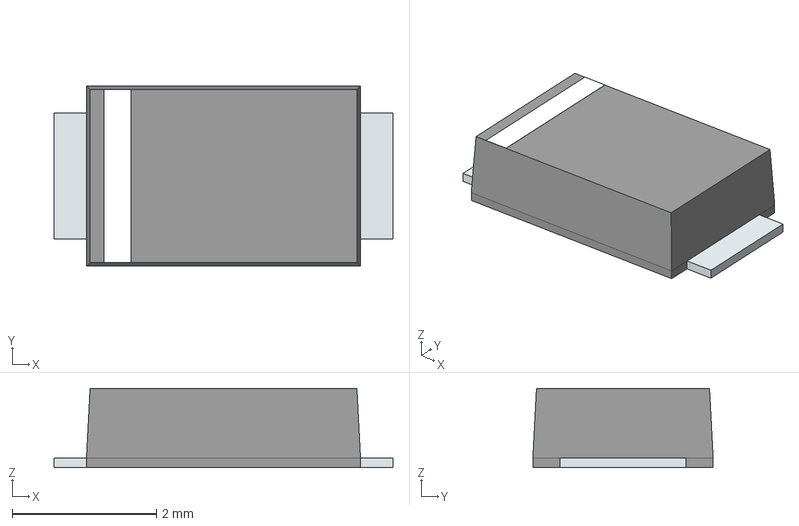
[picture p63: CAD file, 2021-05-24]
3D/VS-3EYH01-M3_H.stp
4.70 x 2.50 x 1.10 mm
PinKIdent
PinK
PinA
