byteofsoren/kicad_bytelib/3D/34-6822.stp

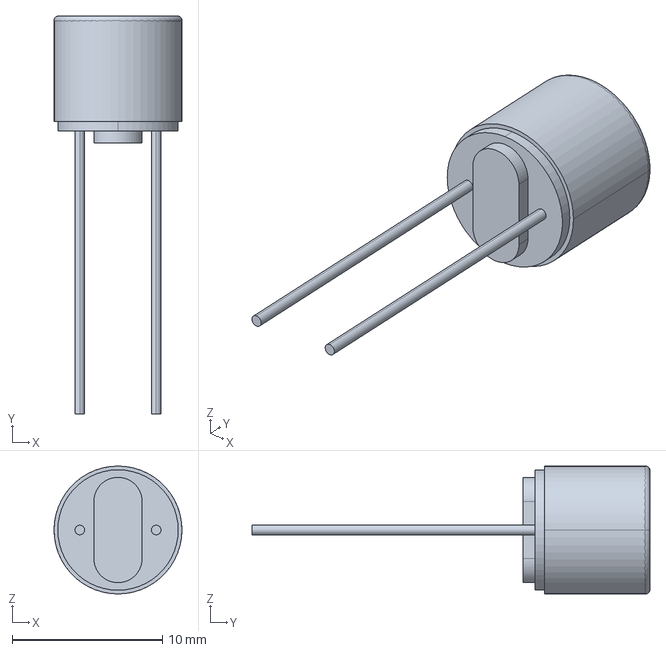
[picture p64: CAD file, 2021-05-24]
3D/34-6822.stp
8.50 x 26.5 x 8.50 mm
