byteofsoren/kicad_bytelib/3D/ 0034.6822 .step

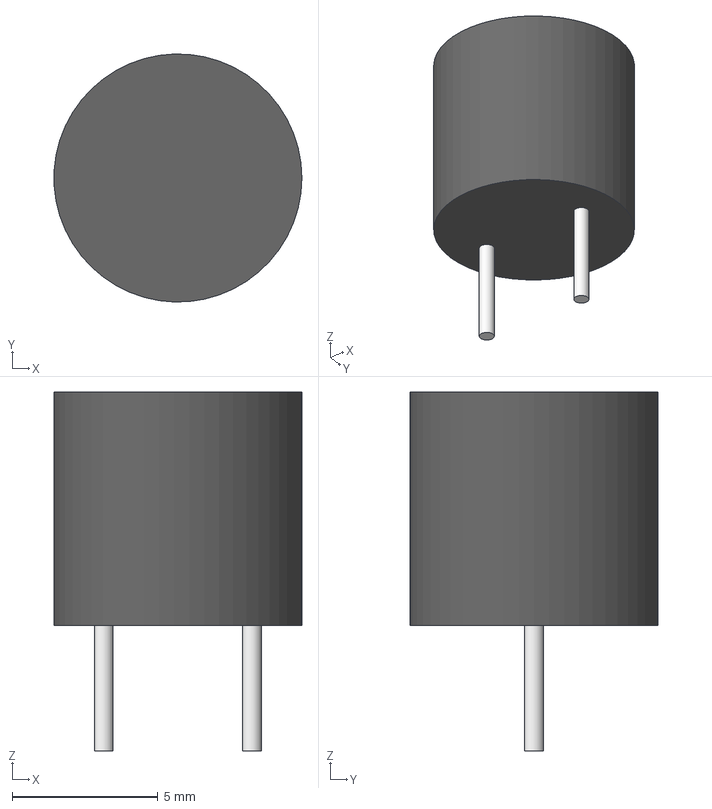
[picture p65: CAD file, 2021-05-24]
3D/ 0034.6822 .step
8.49 x 8.50 x 12.3 mm
