byteofsoren/kicad_bytelib/3D/308-Body.step

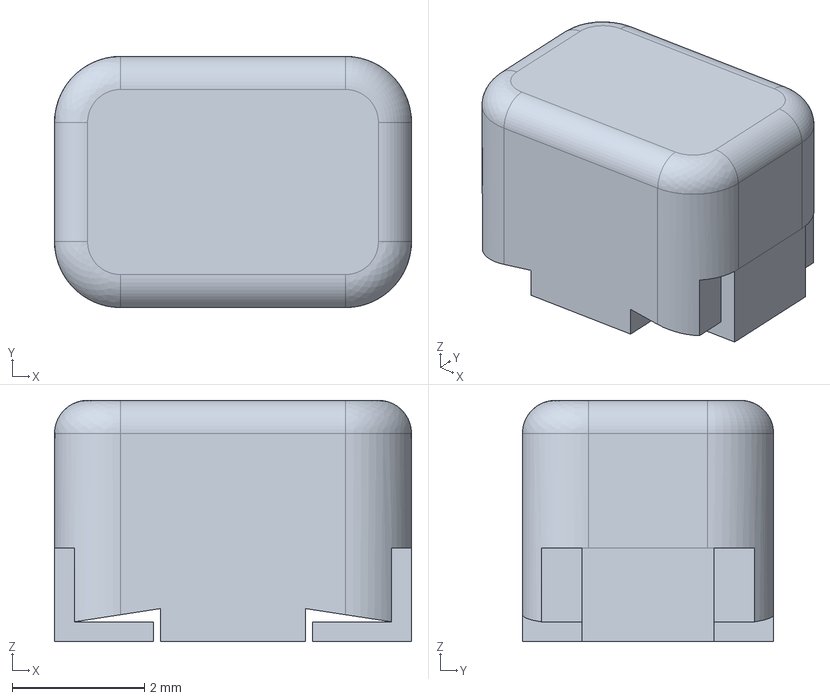
[picture p66: CAD file, 2021-05-24]
3D/308-Body.step
5.40 x 3.80 x 3.65 mm
