byteofsoren/kicad_bytelib/3D/ABPDRRV015PDAA5.step

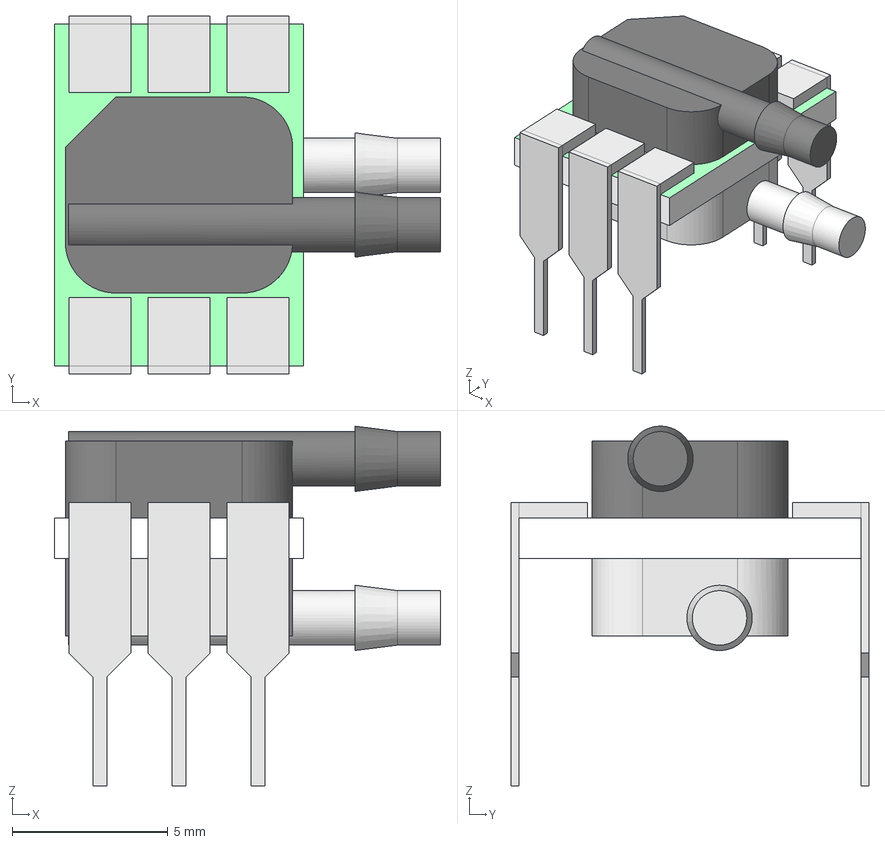
[picture p67: CAD file, 2021-05-24]
3D/ABPDRRV015PDAA5.step
12.4 x 11.5 x 11.6 mm
