byteofsoren/kicad_bytelib/3D/P783F-Q24-S12-S-Body.stl

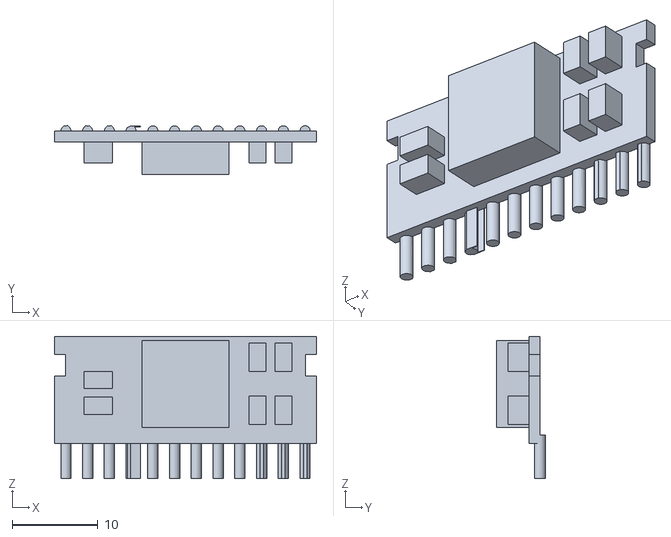
[picture p68: CAD file, 2021-05-24]
3D/P783F-Q24-S12-S-Body.stl
30.6 x 5.71 x 16.6
