byteofsoren/kicad_bytelib/3D/EVQ-Q2U03W.step

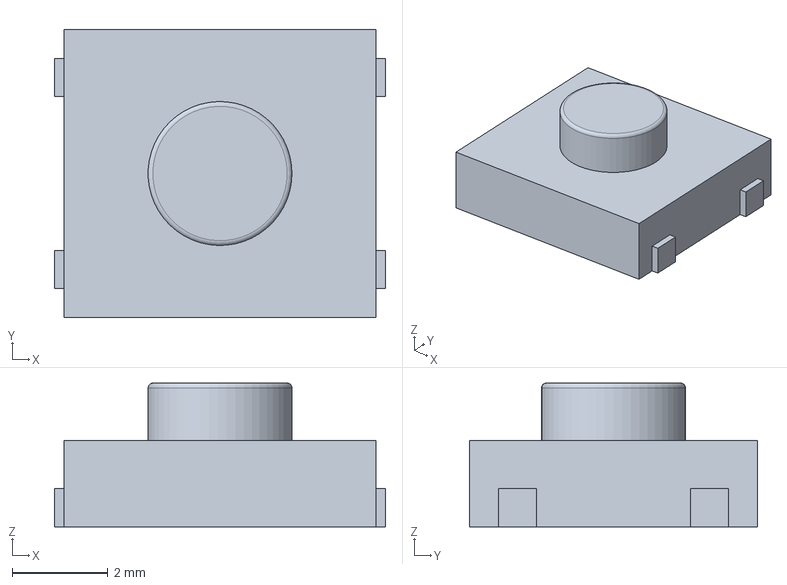
[picture p69: CAD file, 2021-05-24]
3D/EVQ-Q2U03W.step
6.90 x 6.00 x 3.00 mm
