byteofsoren/kicad_bytelib/(list of files, cad)

Other CAD files:
3D/308.step
3D/10A10-T/3D/10A10-T.stl
3D/14011213102000.stp
3D/14111213002000_100549233MOD000A.STP
3D/14311213101000_100551511MOD000A.STP
3D/219-3LPSTR/3D/219-3LPSTR.stl
3D/308-Body.stl
3D/444320802.stp
3D/44769-0801/3D/44769-0801.stp
3D/4628/3D/4628.stl
3D/469930411.stp
3D/61900211121 (rev1).stp
3D/691210910002.stp
3D/691210910004.stp
3D/691210910005/3D/691210910005.stp
3D/691210910005/other3d/691210910005.stl
3D/691210910005/other3d/691210910005.stp
3D/691210910006.stp
3D/691221120002 (rev1).stp
3D/691221120004 (rev1).stp
3D/691221120006.stp
3D/691221320003 (rev1).stp
3D/691243110005.stp
3D/691317410005_Download_STP_691317410005_rev1.stp
3D/691323100002.stp
3D/691323100002_Download_STP_691323100002_rev1.stp
3D/691323100003.stp
3D/691323100005.stp
3D/691323100006.stp
3D/691323100012_Downloads_STP_691323100012_rev1.stp
3D/691325110002.stp
3D/691325110002_Download_STP_691325110002_rev1.stp
3D/691325110003_Download_STP_691325110003_rev1.stp
3D/691325110005 (rev1).stp
3D/691325110006_Download_STP_691325110006_rev1.stp
3D/691325110012_Dwonloads_STP_691325110012_rev1.stp
3D/691340400005_Download_STP_691340400005_rev1.stp
3D/691364100002.stp
3D/691364100002_Download_STP_691364100002_rev1.stp
3D/691364100003.stp
3D/691364100003_Download_STP_691364100003_rev1.stp
3D/691364100005 (rev1).stp
3D/691364100005.stp
3D/691364100006.stp
3D/691364100006_Download_STP_691364100006_rev1.stp
3D/691364100012_Download_STP_691364100012_rev1.stp
3D/691365110012_Download_STP_691365110012_rev1.stp
3D/691367110002_Download_STP_691367110002_rev1.stp
3D/691381030002_Download_STP_691381030002_rev1.stp
3D/691382030002_Download_STP_691382030002_rev1.stp
3D/74404084120/3D/74404084120.stl
3D/74404084120/3D/74404084120.stp
3D/ABPDRRV015PDAA5.stl
3D/ADS7830IPWR/3D/ADS7830IPWR.stl
3D/ADUM1400ARWZ-RL/3D/ADUM1400ARWZ-RL.stl
3D/ADUM4160BRIZ-RL.stl
3D/CMI-9705-0580-SMT-TR/3D/CMI-9705-0580-SMT-TR.stl
3D/CUI_DEVICES_TBL002A-350-06GR-2OR.STL
3D/DLW44SM401SK2L/3D/DLW44SM401SK2L.stl
3D/EDZCVT2R6.8B/3D/EDZCVT2R6.8B.stl
3D/FQT3P20TF/3D/FQT3P20TF.stl
3D/HR10A-10R-12SB.stl
3D/HR10A-10R-12SB.stp
3D/IRF9520NPBF/3D/IRF9520NPBF.stl
3D/LCB717S/3D/LCB717S.stl
3D/LMZM23601V5SILR/3D/LMZM23601V5SILR.stl
3D/MCP23008-E_P/3D/MCP23008-E_P.stl
3D/MCP23008-E_P/3D/MCP23008-E_P.stp
3D/NFM21PC104R1E3D/3D/NFM21PC104R1E3D.stl
3D/NTJS3151PT1G/3D/NTJS3151PT1G.stl
3D/NX2016SA-32M-EXS00A-CS06465/3D/NX2016SA-32M-EXS00A-CS06465.stl
3D/P78E05-1000/3D/P78E05-1000.stl
3D/RPMB12-3.0-CT/3D/RPMB12-3.0-CT.stl
3D/SI8602AC-B-ISR/3D/SI8602AC-B-ISR.stl
3D/SI8641AB-B-IS1R/3D/SI8641AB-B-IS1R.stl
3D/SM4001PL-TP/3D/SM4001PL-TP.stl
3D/STM32WB55RGV6/3D/STM32WB55RGV6.stl
3D/TL3780AF240QG.stl
3D/TMUX1247DCKR/3D/TMUX1247DCKR.stl
3D/TPS2120YFPR/3D/TPS2120YFPR.stl
3D/TSC-124D3H,000/3D/TSC-124D3H,000.stl
3D/UA78M33CDCYR/3D/UA78M33CDCYR.stl
3D/UWT1H101MNL1GS/3D/UWT1H101MNL1GS.stl
3D/VS-3EYH01-M3_H.stl
