byteofsoren/kicad_bytelib/(list of files, drawings)

Other design files:
spice_models/OPA355_PSPICE_AIO/OPA355.DSN
spice_models/OPA355_PSPICE_AIO/OPA355.OLB
spice_models/OPA355_PSPICE_AIO/OPA355.opj
