byteofsoren/kicad_bytelib/(commit log)

2021-03-08 added a new update.sh that removes local paths form the symbols/footprints libaries.
2021-03-08 changed the conf/gen.sh so it can gereratet the update files for the symbols and footprints
2021-03-23 Added new footprint
2021-03-24 the new insert.sh script done
2021-04-20 0308.kicad_mod included
2021-05-24 3D files added
    [0034.6822 .step, 10A10-T.stl, 10A10-T.stp, 10x10.5x4.5.stp, 12.5x14x4.5.stp, 16x17x7.stp, 219-3LPSTR.stl, 219-3LPSTR.stp]
2021-06-01 New footprint 961210910005
    [691210910005.stl, 691210910005.stp]
2021-06-15 added a connector
    [61900211121 (rev1).stp]
2021-08-01 aded TBL002A
    [CUI_DEVICES_TBL002A-350-04GR-2OR.step, CUI_DEVICES_TBL002A-350-06GR-2OR.STL, CUI_DEVICES_TBL002A-350-06GR-2OR.step]
2021-08-03 TPS2121 changed and added 3D model
    [TPS2121RUXR.step]
2021-09-27 New symbols
    [14011213102000.stp, 691210910002.stp, 691210910004.stp, 691210910006.stp, ADUM4160BRIZ-RL.stl, ADUM4160BRIZ-RL.stp, TEN_3-0510N.stp, TL3780AF240QG.stl]
2021-12-06 Changed to HTTPS
    [691243110005.stp]
2021-12-19 Changed fottprint on a few components to bytelib
    [VS-3EYH01-M3_H.stl, VS-3EYH01-M3_H.stp, WE-CNSW_1206_CNSW.stp]
2022-01-19 Moved to KiCAD6, the .kicad_sym is the new .pretty file format. Keaping the old format for backward compability but is considerd depricatod
    [THN_15-1210.stp]
2022-03-26 Added few new components
    [14111213002000_100549233MOD000A.STP, 14311213101000_100551511MOD000A.STP, OPA355.DSN, OPA355.OLB, OPA355.opj, WE-PD_744777.stp]
2022-04-08 Added 4 2004 90-1X12P connector
